ManoloMancelli/Persephone-3-Pro/README.md

# Persephone 3 Pro

Persephone 3 Pro is a DiY SteamVR headset which features full Lighthouse tracking (6DoF), pseudo-pancake lenses and 1440x1440 resolution per eye.

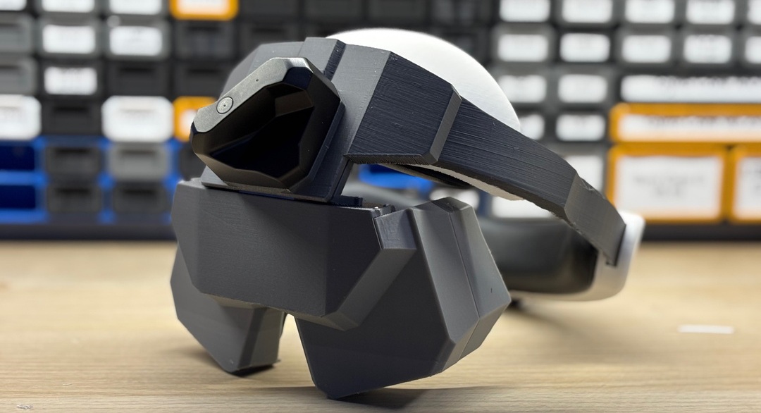
[picture p1: Releases/1.0/img/1.jpeg]


### Releases
- #### [Persephone 3 Pro 1.0](/Releases/1.0/1.0.md)
- #### [Persephone 3 Pro 1.1 - Wip](/Releases/1.1/1.1.md)

### Tutorials
- #### [SteamVR Tracking Override](/Tutorials/SteamVR%20Tracking%20Override/SteamVR%20Tracking%20Override.md)

### Software
- #### [HadesVR Eye Roll Fix](/Software/Eye%20Roll%20Fix/driver_hadesvr.dll)
- #### [Experimental HadesVR firmware for RP2040](/Software/Headset%20RP2040%20-%20Experimental)

### Reference
- #### [RP2040 Pro Micro Pinout](/Hardware/RP2040%20Pro%20Micro%20Pinout.png)
- #### [RP2040 Schematics](/Hardware/RP2040_Zero.pdf)
- #### [Waveshare RP2040 Zero Pinout](/Hardware/Waveshare%20RP2040%20Zero%20Pinout.png)
- #### [Waveshare RP2040 Zero Wiring](/Hardware/Wiring.png)
- #### [Face Tracking 1](https://www.reddit.com/r/VRchat/comments/1jbjmhd/25_wireless_face_tracking_for_vrchat/)
- #### [Face Tracking 2](https://steamcommunity.com/sharedfiles/filedetails/?id=3493715993)
- #### [Face Tracking 3](https://github.com/Project-Babble/ProjectBabble)
- #### [Eye Tracking 1](https://hackaday.com/2023/08/05/diy-eye-tracking-for-vr-headsets-from-a-to-z/)
- #### [Eye Tracking 2](https://docs.eyetrackvr.dev/getting_started/intro)
