ManoloMancelli/Persephone-3-Pro/Releases/1.0/1.0.md

# Persephone 3 Pro 1.0



## Parts
- #### [Display Set - LS029B3SX02](https://aliexpress.com/item/1005005565755501.html)
- #### [Tundra Tracker](https://tundra-labs.com/?srsltid=AfmBOoopuOi3vYniPcr9jf2mklbutnyBmwqGddzbK_AnHrIck0Ho1YlA)
- #### [2x Fresnel Lense - Diameter 70mm Focal Lenght 30mm](https://www.aliexpress.com/item/1005006877466030.html)
- #### [2x Fresnel Lense - Diameter 70mm Focal Lenght 40mm](https://www.aliexpress.com/item/1005006877466030.html)
- #### [Self Tapping Screws - M1.4 8mm](https://www.aliexpress.com/item/4000982209705.html)

## 3D files
You can use either CAD or STL files. CAD are meant to be used if you want to modify the design.

- #### [CAD Files](https://www.patreon.com/posts/150849423/)
- #### [STL Files](https://www.patreon.com/posts/150851033/)

## PCB files
This board uses all of the components which come with the original display kit.

You are meant to transfer them from the original PCB.

This board may be difficult to solder if you never soldered before!

- #### [MIPI Connector PCB](https://www.patreon.com/posts/151093496/)

## Tools
- #### [Lense Cutting Jig - Wip]()
- #### Hot air station
- #### Hot plate (Optional)

## Changelogs
- #### [Front Housing](/Changelogs/V1.0/Front%20Housing/Front%20Housing.md)
- #### [Headband](/Changelogs/V1.0/Headband/Headband.md)
- #### [Display Frame](/Changelogs/V1.0/Display%20Frame/Display%20Frame.md)
- #### [Optics](/Changelogs/V1.0/Optics/Optics.md)
- #### [Optics Housing](/Changelogs/V1.0/Optics%20Housing/Optics%20Housing.md)
- #### [IPD PCB](/Changelogs/V1.0/IPD%20PCB/IPD%20PCB.md)
