ManoloMancelli/Persephone-3-Pro/Changelogs/V1.0/Optics Housing/Optics Housing.md

# Persephone 3 Pro Optics Housing

A 3D printed optics housing which features Eye Tracking cameras and works with my custom pseudo pancake lenses.

## Optics Housing no. 1
Very first version of the Optics Housing. Based on the previous Persephone headsets.
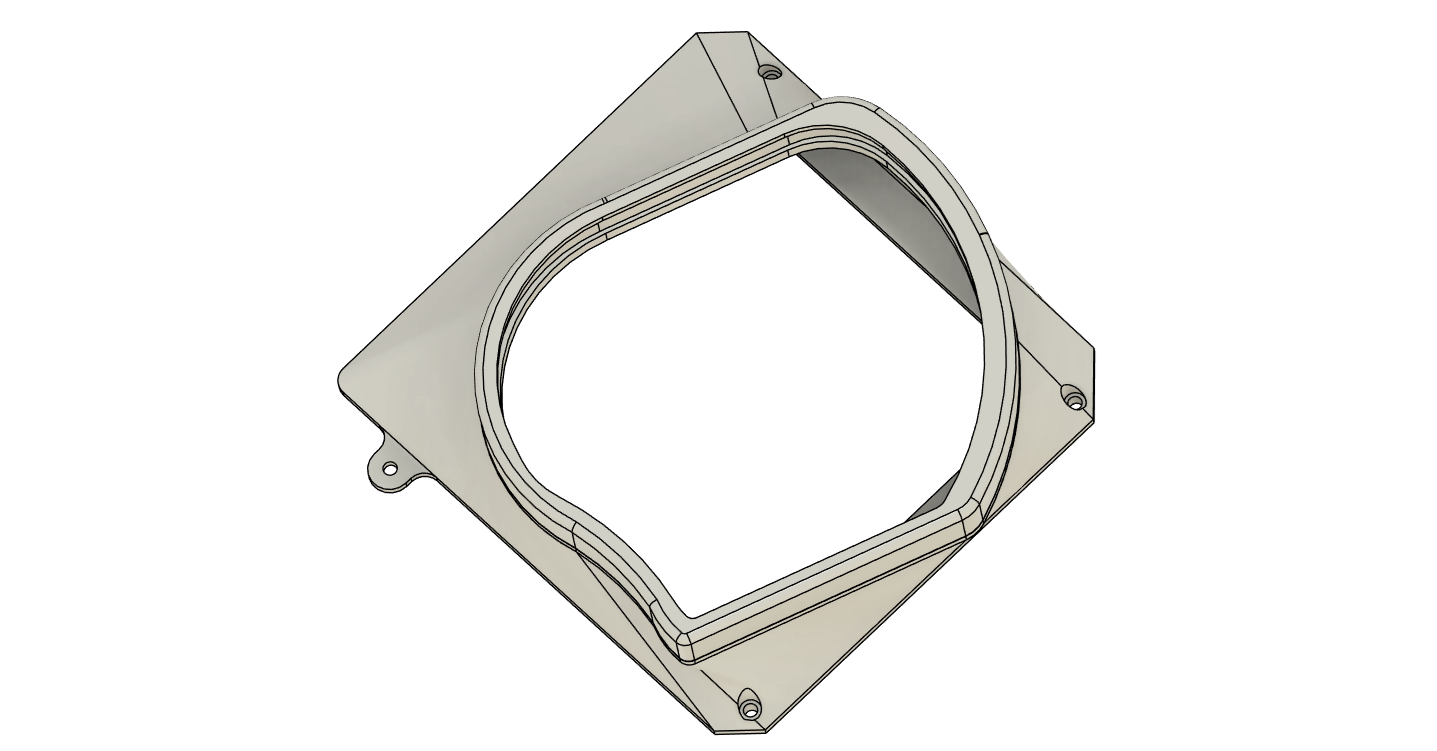
[picture p2: Changelogs/V1.0/Optics Housing/img/1/1.png]

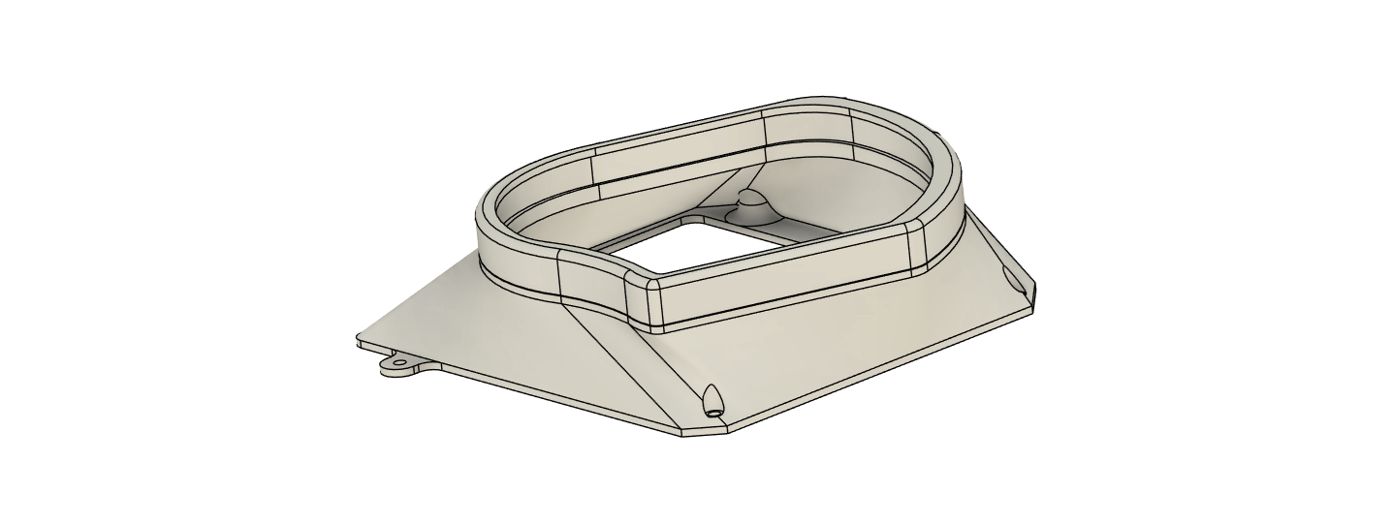
[picture p3: Changelogs/V1.0/Optics Housing/img/1/2.png]


## Optics Housing no. 2
- Modified the Optics Housing for use with new Lense trim
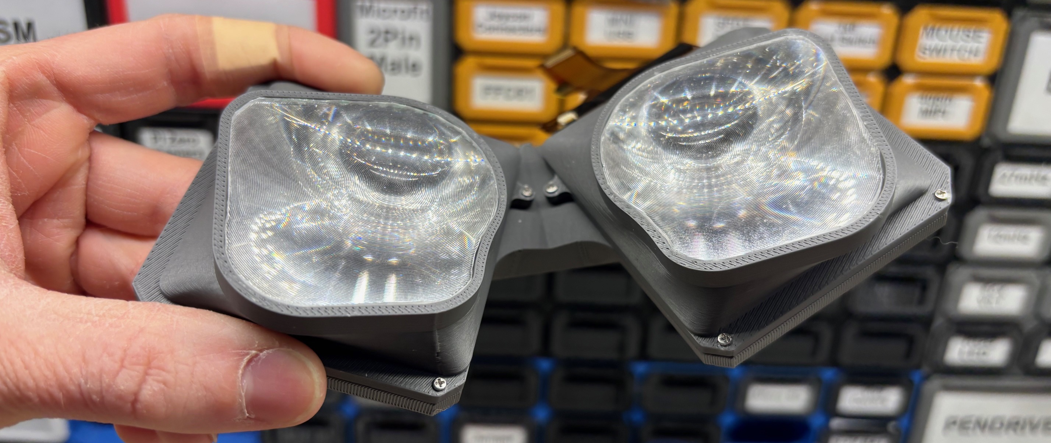
[picture p4: Changelogs/V1.0/Optics Housing/img/2/1.jpeg]

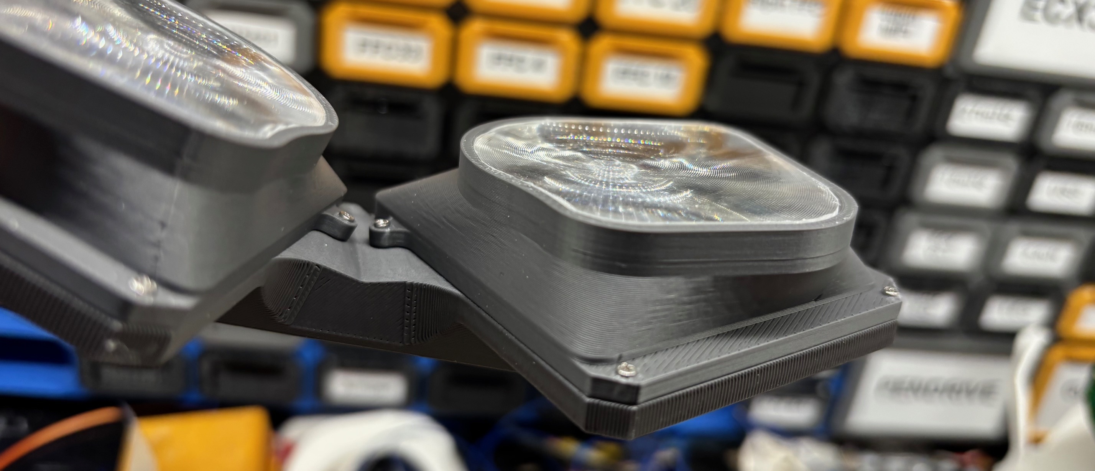
[picture p5: Changelogs/V1.0/Optics Housing/img/2/2.jpeg]

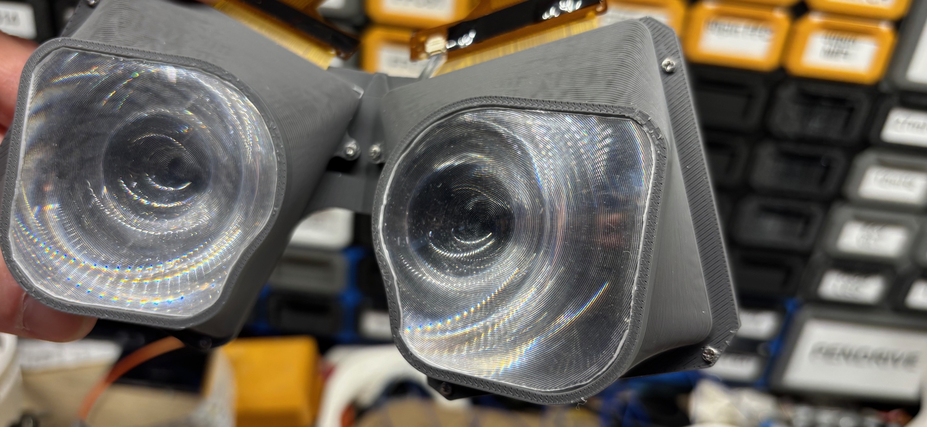
[picture p6: Changelogs/V1.0/Optics Housing/img/2/3.jpeg]


## Optics Housing no. 3
- Modified the Lense Holder for use with Lense Caps
- Added Lense Caps
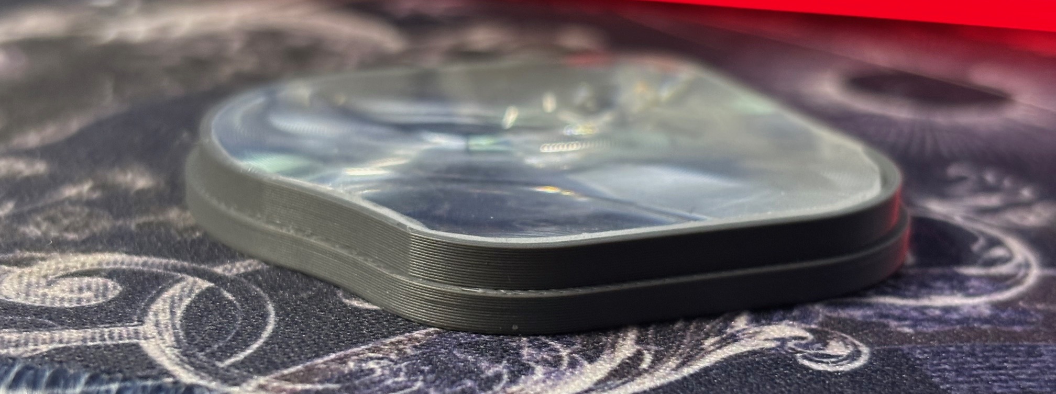
[picture p7: Changelogs/V1.0/Optics Housing/img/3/1.jpeg]

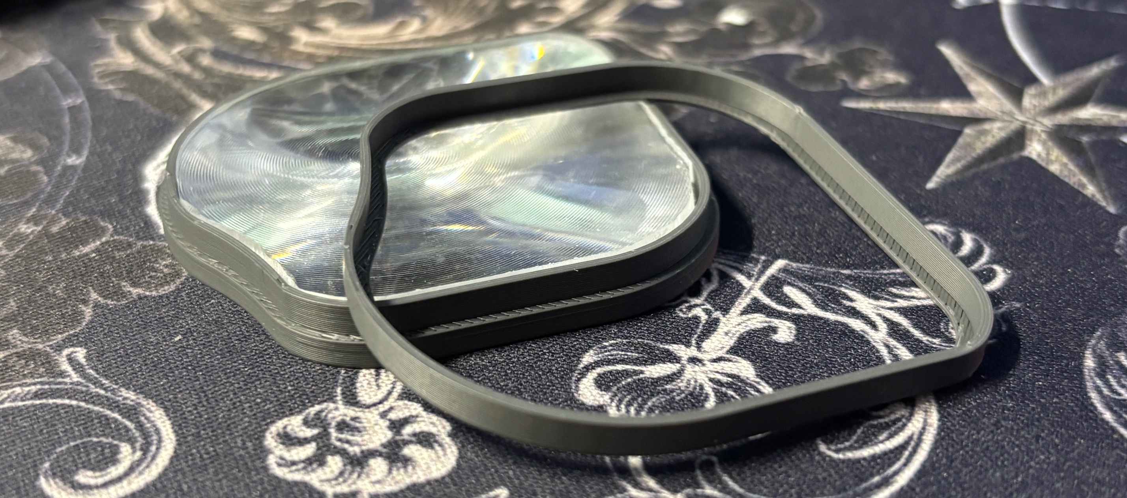
[picture p8: Changelogs/V1.0/Optics Housing/img/3/2.jpeg]
