ManoloMancelli/Persephone-3-Pro/Hardware/RP2040 Pro Micro Pinout.png

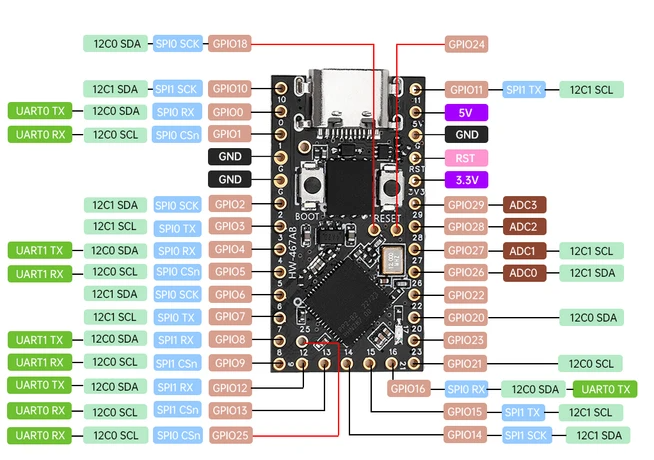
Hardware/RP2040 Pro Micro Pinout.png
