ManoloMancelli/Persephone-3-Pro/Hardware/Waveshare RP2040 Zero Pinout.png

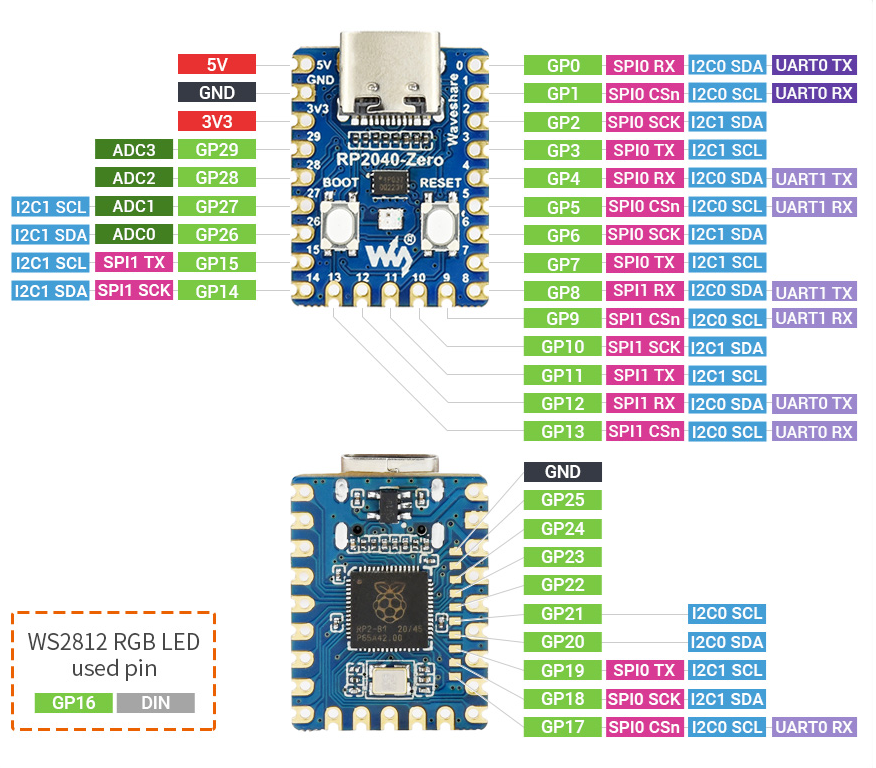
Hardware/Waveshare RP2040 Zero Pinout.png
