ManoloMancelli/Persephone-3-Pro/Releases/1.0/img/2.jpeg

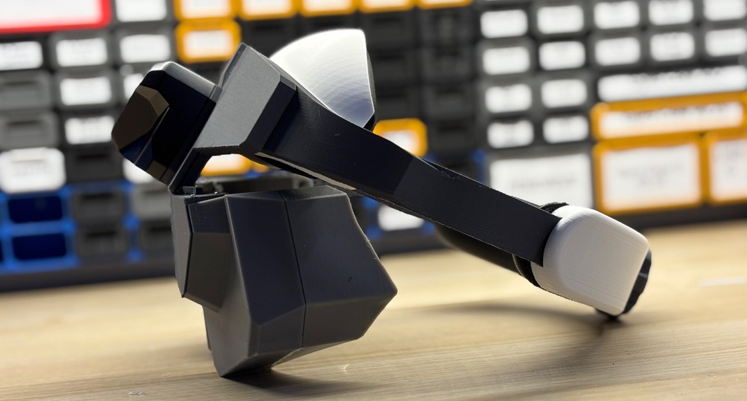
Releases/1.0/img/2.jpeg
