ManoloMancelli/Persephone-3-Pro/Hardware/Wiring.png

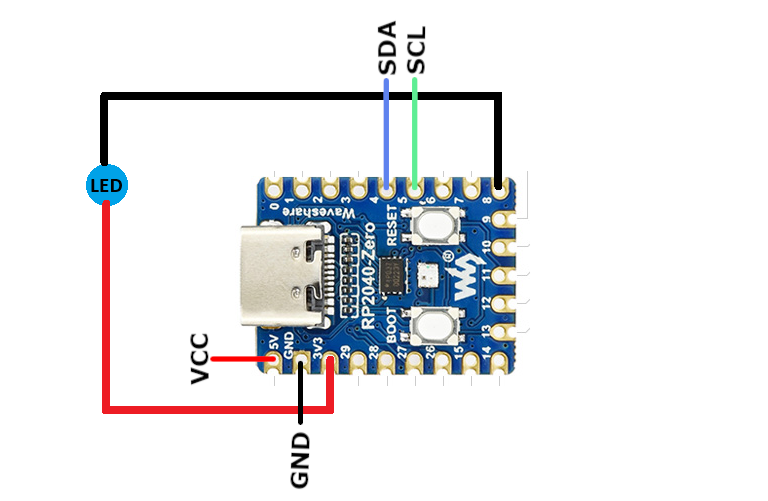
Hardware/Wiring.png
