ManoloMancelli/Persephone-3-Pro/Changelogs/Eye Tracking.md

# Persephone 3 Pro Eye Tracking
Experimental Eye Tracking for Persephone 3 Pro

## 26.01.2026

## TODO
- Check if regular webcam can be used
- Check what kind of material is required for hotmirror
- Check what kind of SteamVR support can be achieved

# References
## Hackaday Eye Tracking

Eye tracking is a useful feature in social virtual reality (VR) spaces because it really enhances presence and communication

when one’s avatar has a realistic gaze. Most headsets lack this feature,

but EyeTrackVR has a completely open source solution ready for anyone willing to put it together.

##

EyeTrackVR is a combination of hardware, software, and 3D printable mounts for attaching a pair of microcontroller boards,

cameras, and IR LEDs to just about any existing VR headset out there.

An ESP32-based board and tiny camera module watches each eyeball, and under IR illumination the pupil presents as an easily-identified round black area.

Software takes care of turning the camera’s view of the pupil into a gaze direction value that can be plugged into other software.

##

The project is still under active development, but in its current state is perfectly suitable for creating a functional system

that can integrate into a variety of existing headsets with printed mounting brackets. 

Interested? Check out the intro and if it sounds up your alley, dive into the build guide which spells out everything you need to know.

## Eye Tracking no. 1
- Find a suitable, small camera
- Look into "hot mirrors"
- Build a prototype
