ManoloMancelli/Persephone-3-Pro/Changelogs/HDMI Breakout PCB.md

# Persephone 3 Pro HDMI Breakout PCB
A Simple DiY PCB which aims to replace the HDMI and USB connectors on the display driver board with more modern variants while also making it possible to move the connectors to a different location
