ManoloMancelli/Persephone-3-Pro/Changelogs/V3.0/Changelog.md

# Persephone 3 Pro Changelog

- #### [Front Housing](/Changelogs/Front%20Housing/Front%20Housing.md)
- #### [Visor](/Changelogs/Visor.md)
- #### [Headband](/Changelogs/Headband/Headband.md)
- #### [Display Frame](/Changelogs/Display%20Frame/Display%20Frame.md)
- #### [Optics](/Changelogs/Optics/Optics.md)
- #### [Optics Housing](/Changelogs/Optics%20Housing/Optics%20Housing.md)
- #### [IPD Mechanism](/Changelogs/IPD%20Mechanism.md)
- #### [IPD PCB](/Changelogs/IPD%20PCB/IPD%20PCB.md)
- #### [HDMI Breakout PCB](/Changelogs/HDMI%20Breakout/HDMI%20Breakout%20PCB.md)
- #### [Eye tracking](/Changelogs/Eye%20Tracking.md)
- #### [Face Tracking](/Changelogs/Face%20Tracking/Face%20Tracking.md)
