ManoloMancelli/Persephone-3-Pro/Changelogs/V1.1/V1.1.md

# Persephone 3 Pro V1.1 Changelog

## 1.03.2026
- Modeled initial version of the TPU Light Blockers
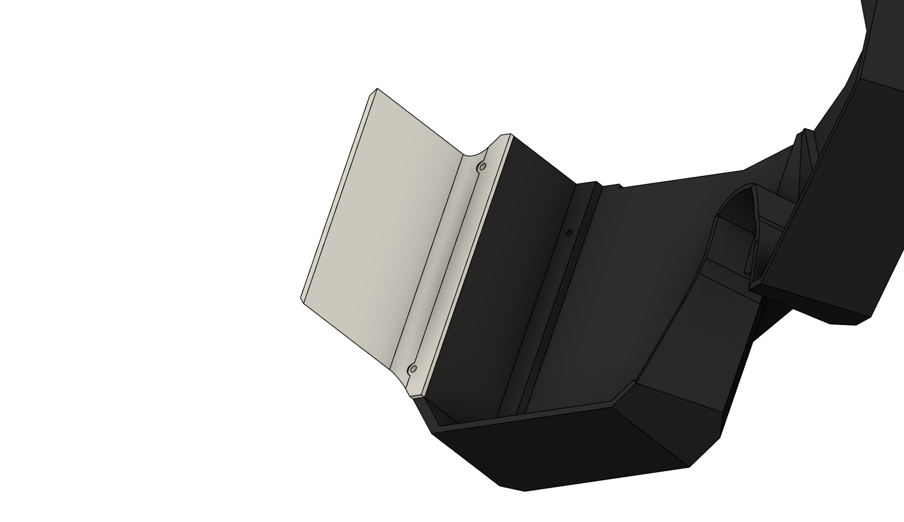
[picture p26: Changelogs/V1.1/1.03.2026/1.png]


## 2.03.2026
- Changed Optics mounting system to slide-in
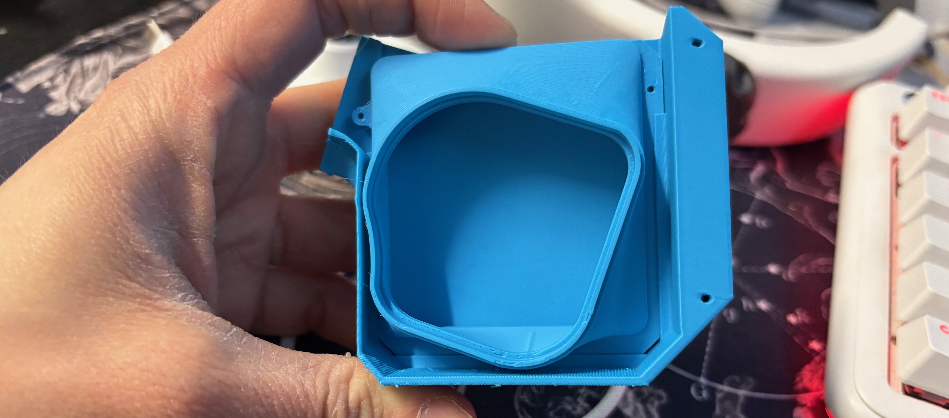
[picture p27: Changelogs/V1.1/2.03.2026/1.jpeg]


## 6.03.2026
- Added Persephone 3 Pro logo on the top part of Rear Headband Mechanism
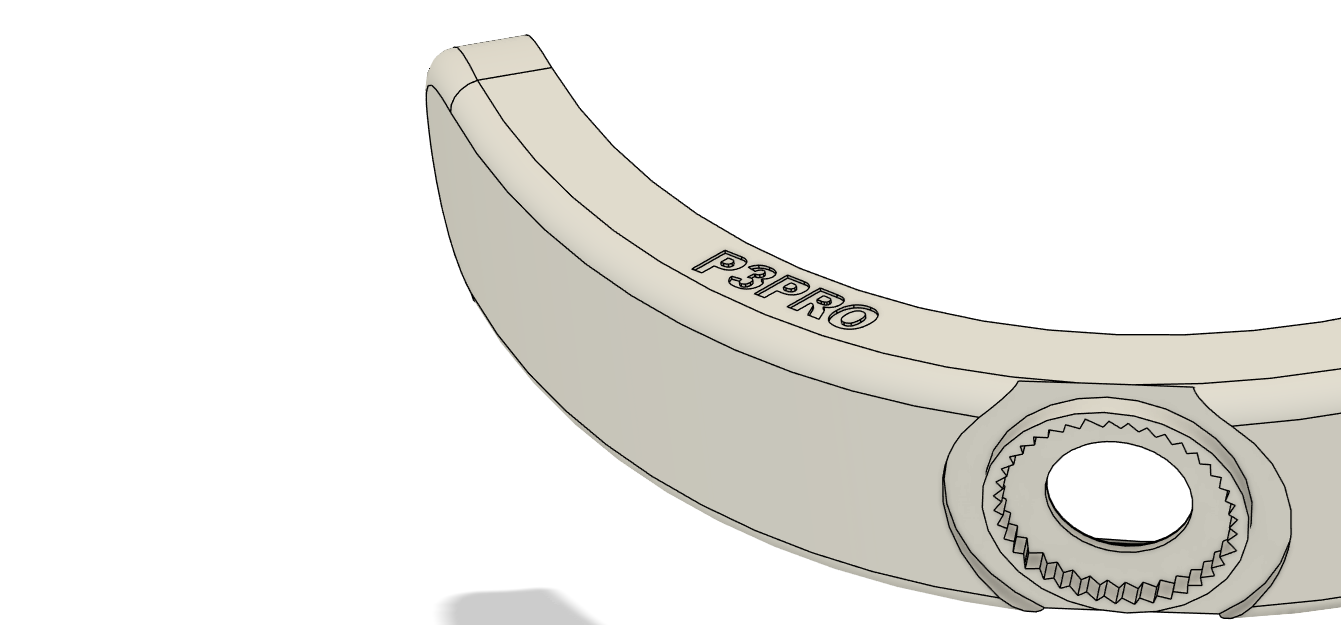
[picture p28: Changelogs/V1.1/6.03.2026/1.png]


- Made the Rear Headband Mechanism Cover mounting points tighter
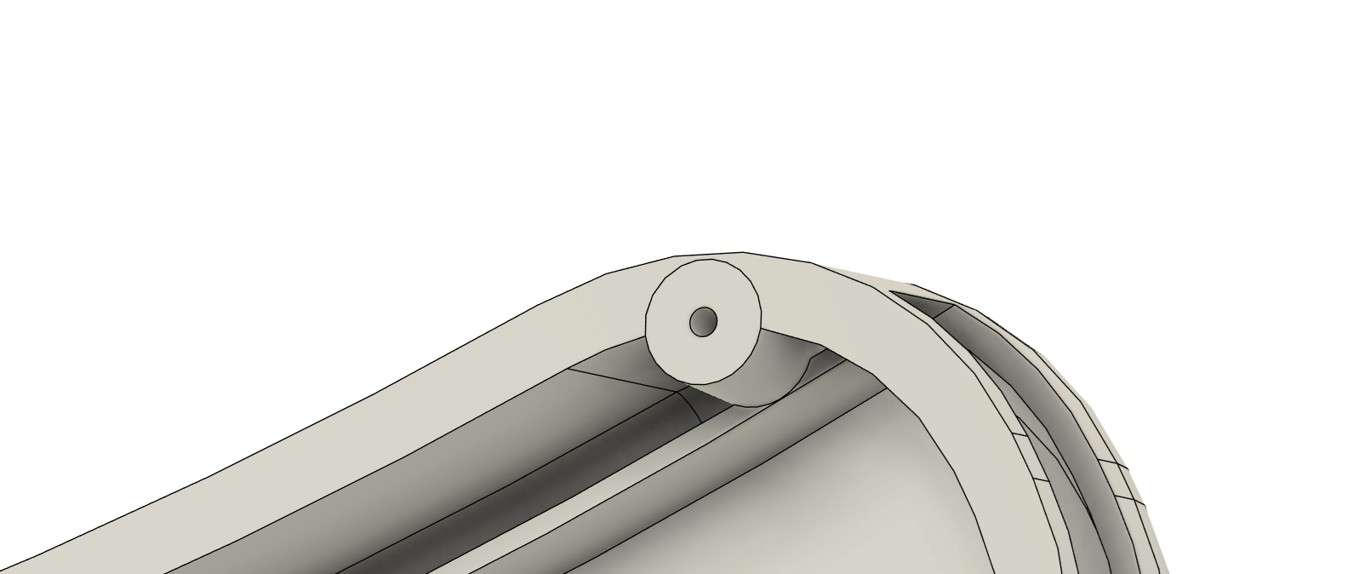
[picture p29: Changelogs/V1.1/6.03.2026/2.png]


- Made the Strap openings on the Rear Headband Mechanism slightly narrower
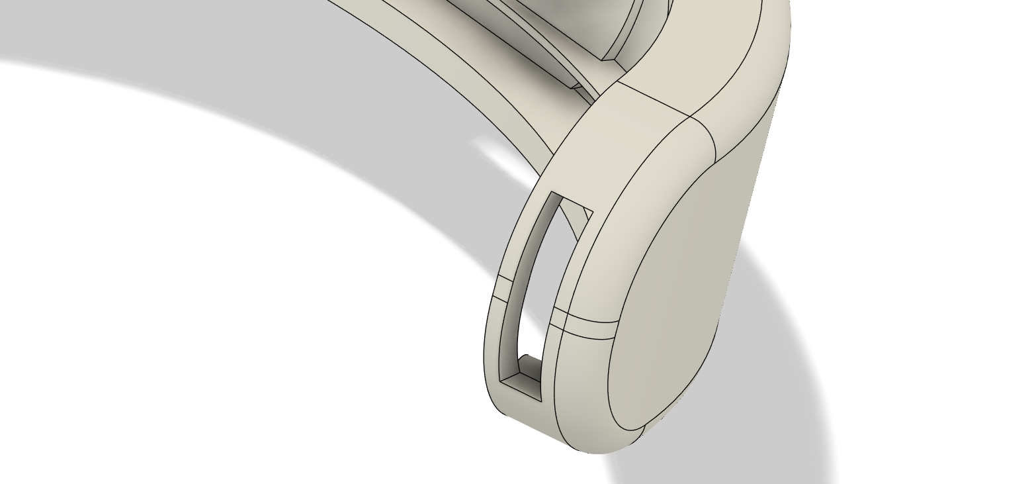
[picture p30: Changelogs/V1.1/6.03.2026/3.png]


- Extended the Rear Headband Mechanism Cover center mounting points to the sides
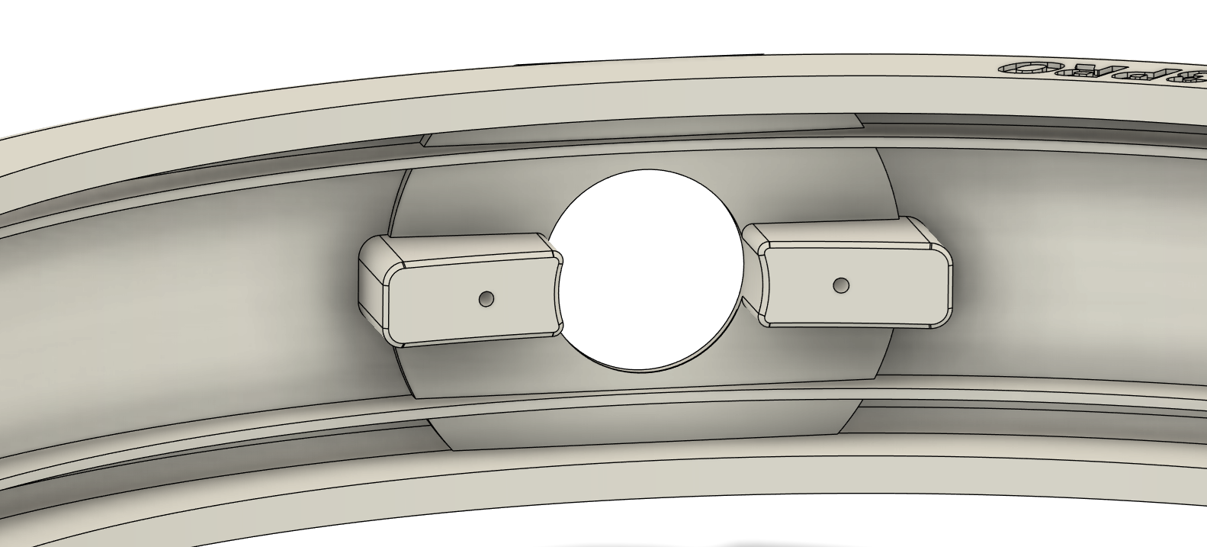
[picture p31: Changelogs/V1.1/6.03.2026/4.png]


- Modified the Knob for the stationary logo
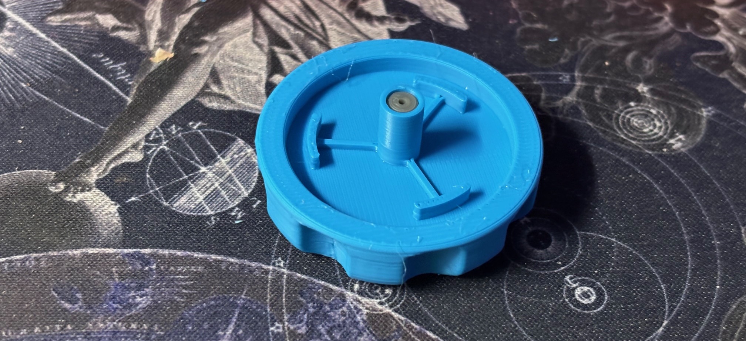
[picture p32: Changelogs/V1.1/6.03.2026/5.jpeg]

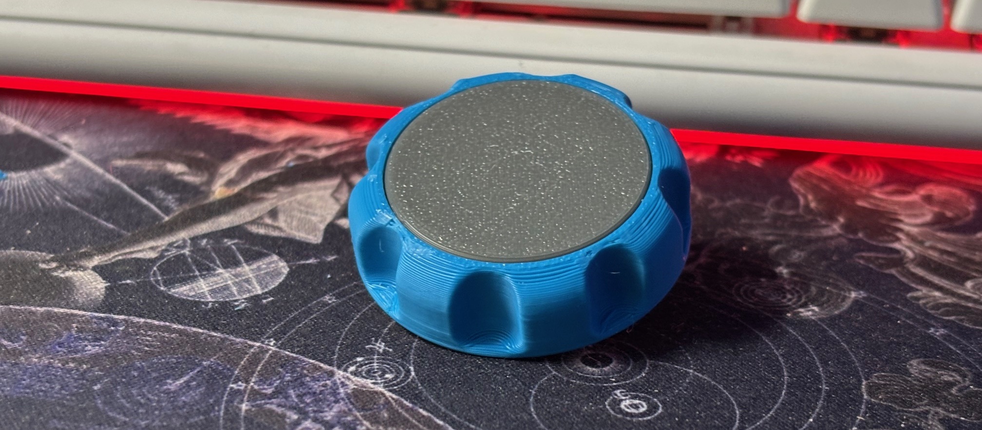
[picture p33: Changelogs/V1.1/6.03.2026/6.jpeg]


- Merged Knob Lock with Headband Mechanism Cover
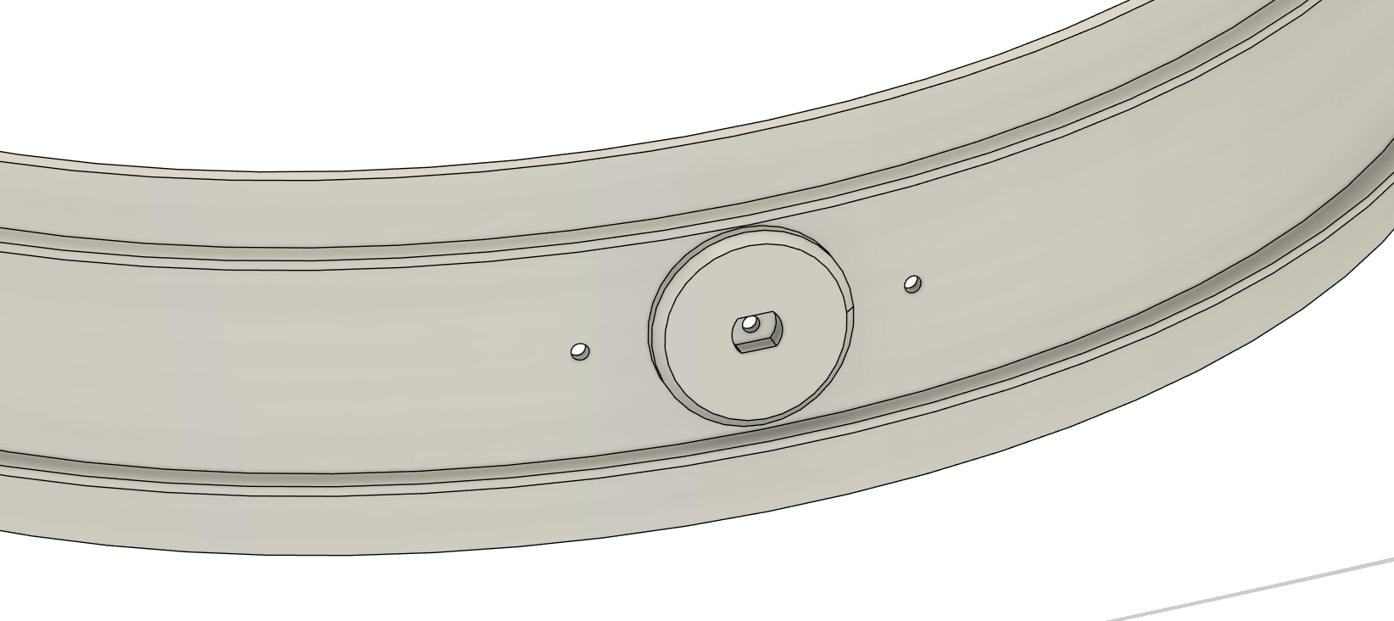
[picture p34: Changelogs/V1.1/6.03.2026/7.png]


- Added Logo on the Knob
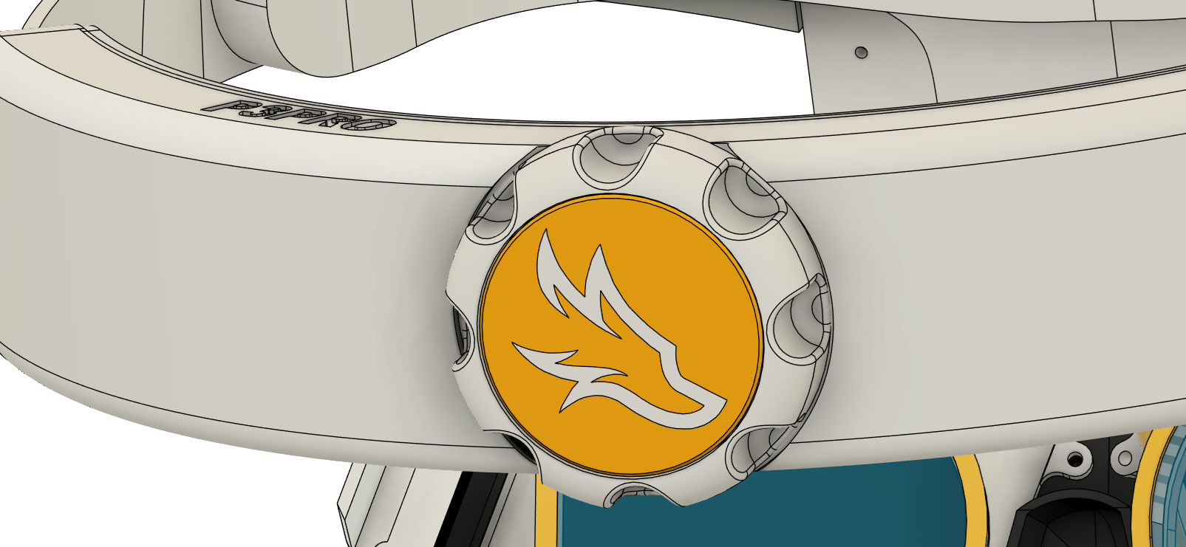
[picture p35: Changelogs/V1.1/6.03.2026/8.png]


- Changed Halo-Headset mounting system to slide-in
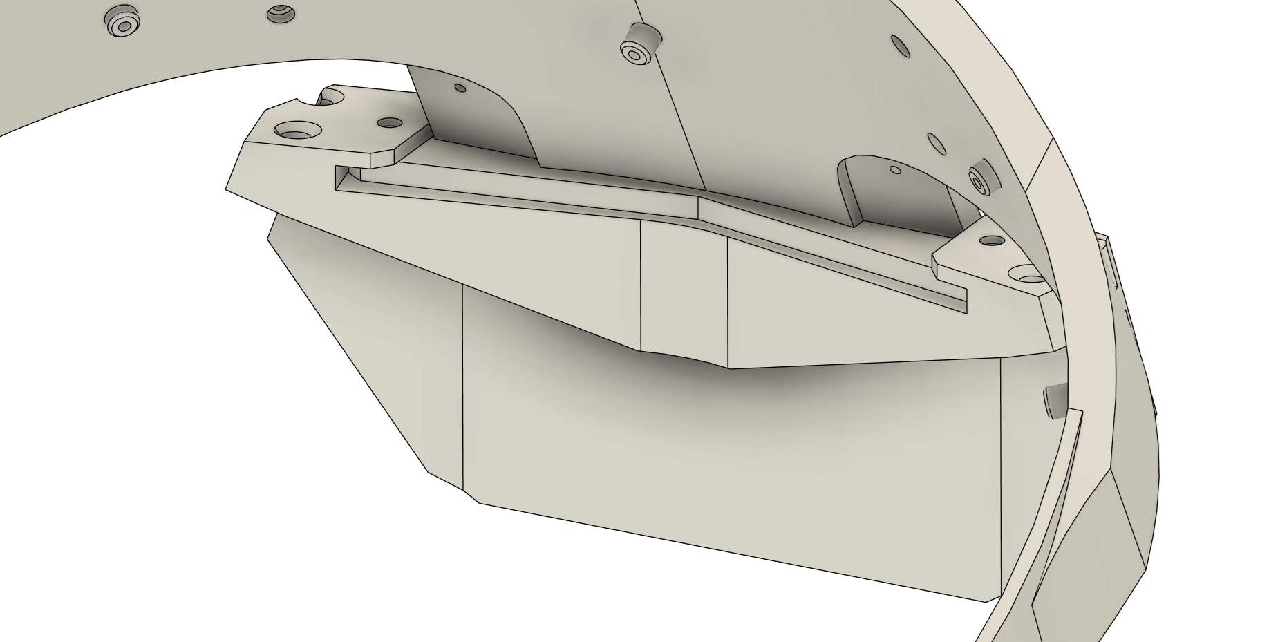
[picture p36: Changelogs/V1.1/6.03.2026/9.png]


## 7.03.2026
- Improved the Rear Headband Mechanism geometry
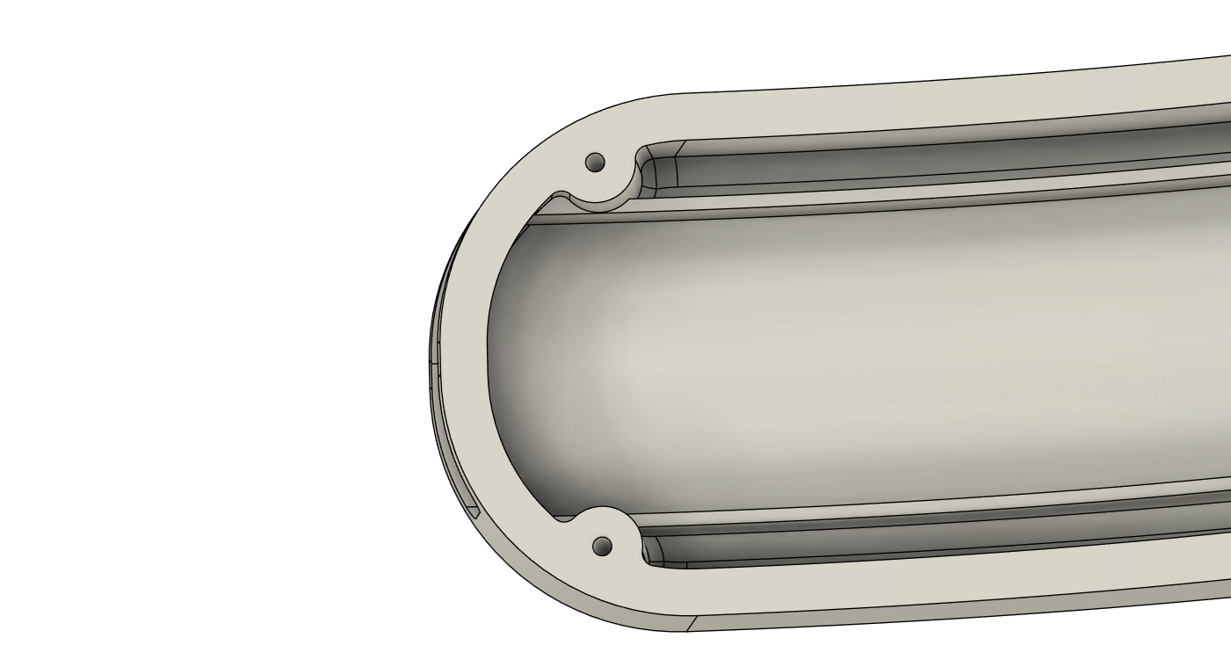
[picture p37: Changelogs/V1.1/7.03.2026/1.png]


- Made the Display Frame slightly wider
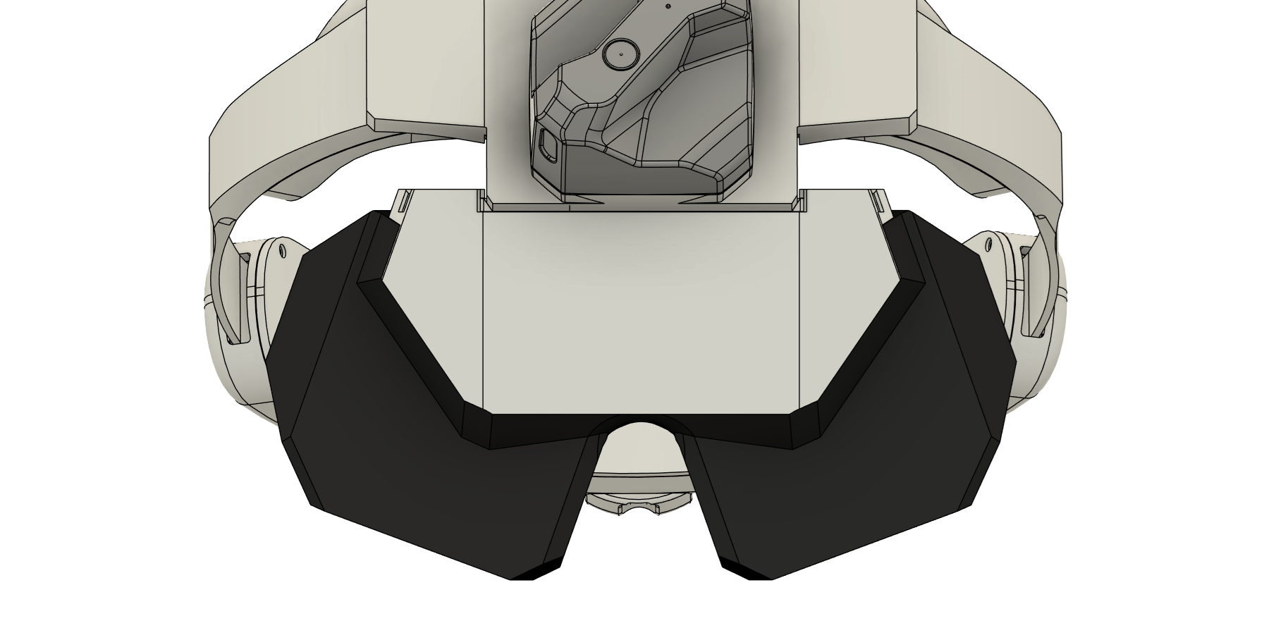
[picture p38: Changelogs/V1.1/7.03.2026/2.png]


- Extended Headstrap "Endstops"
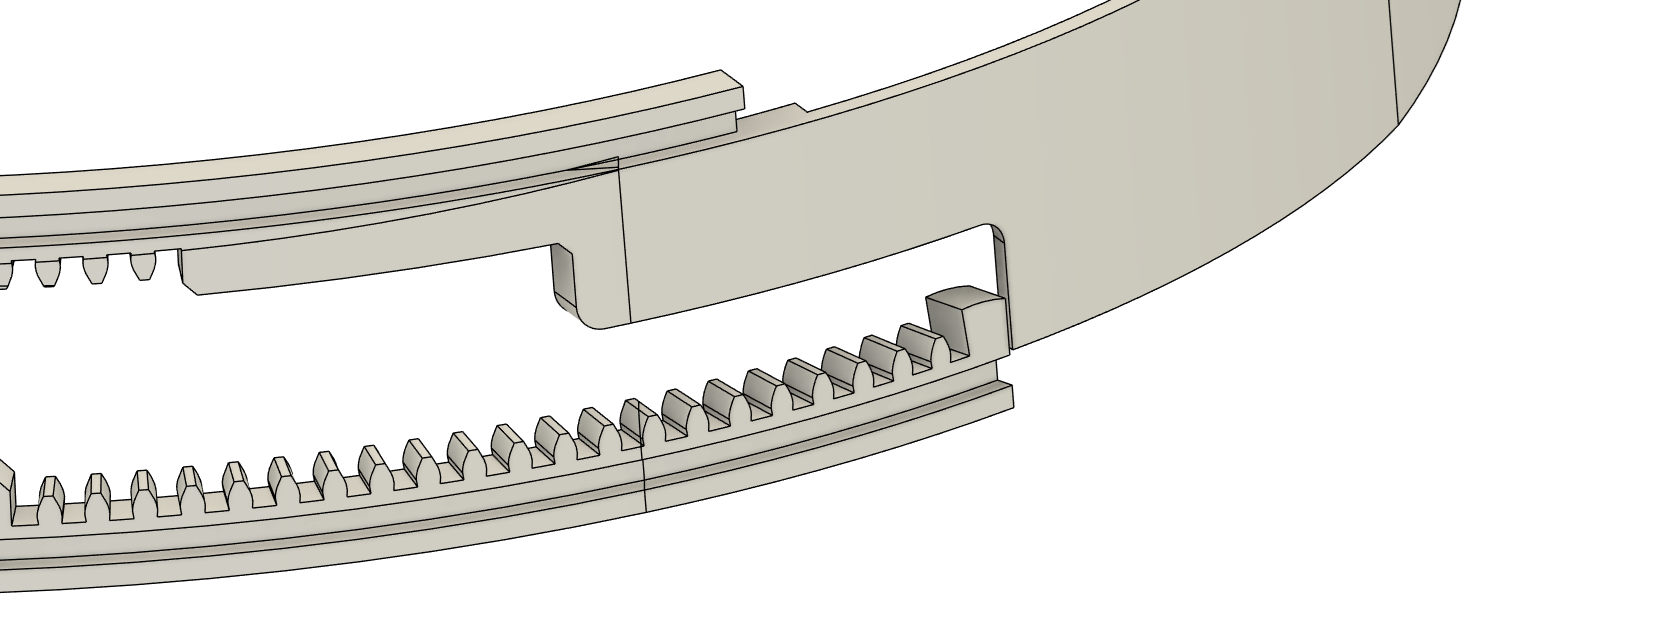
[picture p39: Changelogs/V1.1/7.03.2026/3.png]


## 14.03.2026
- Moved the strap cutout covers to the Rear Headband Cover
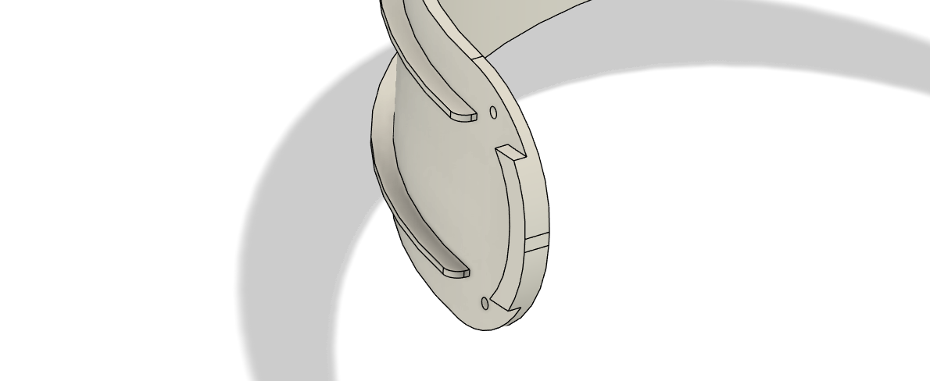
[picture p40: Changelogs/V1.1/14.03.2026/1.png]


- Added Strap max limiter
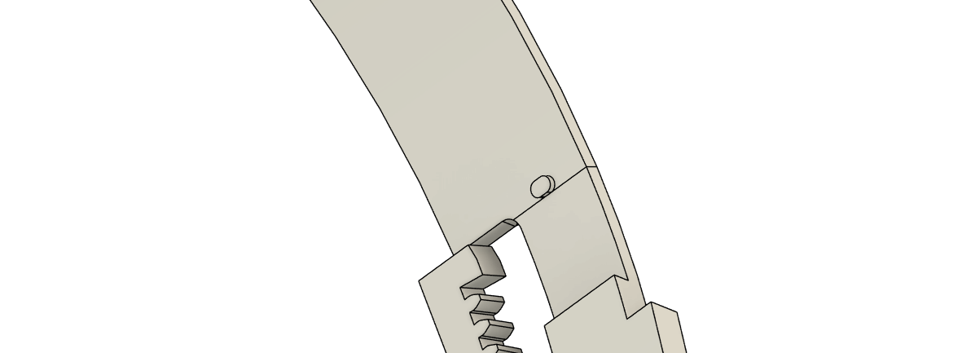
[picture p41: Changelogs/V1.1/14.03.2026/2.png]


- Adjusted the USB and HDMI cutouts on the Headband
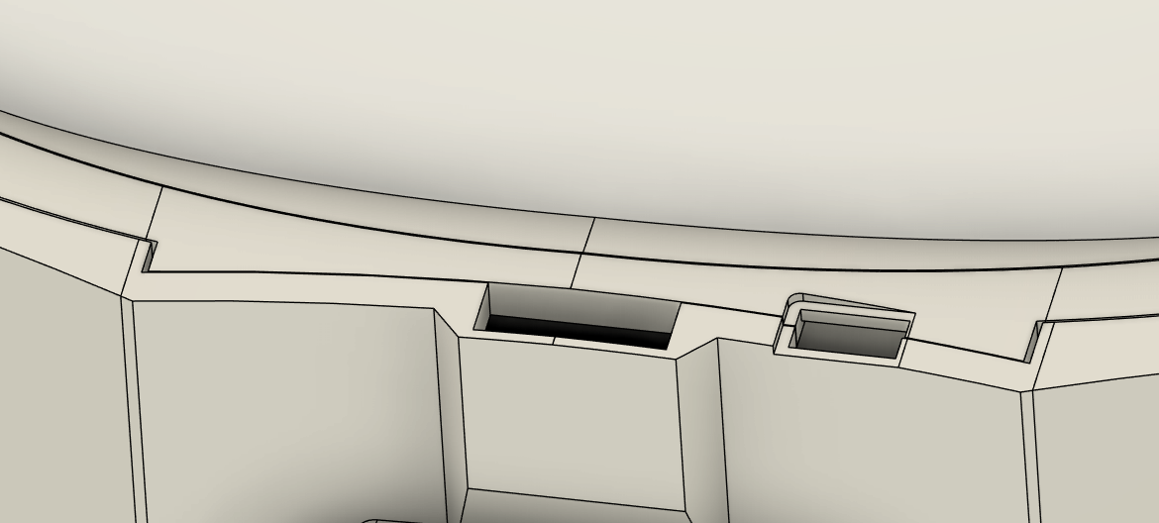
[picture p42: Changelogs/V1.1/14.03.2026/3.png]


## 16.03.2026
- Extended the Strap max limiters
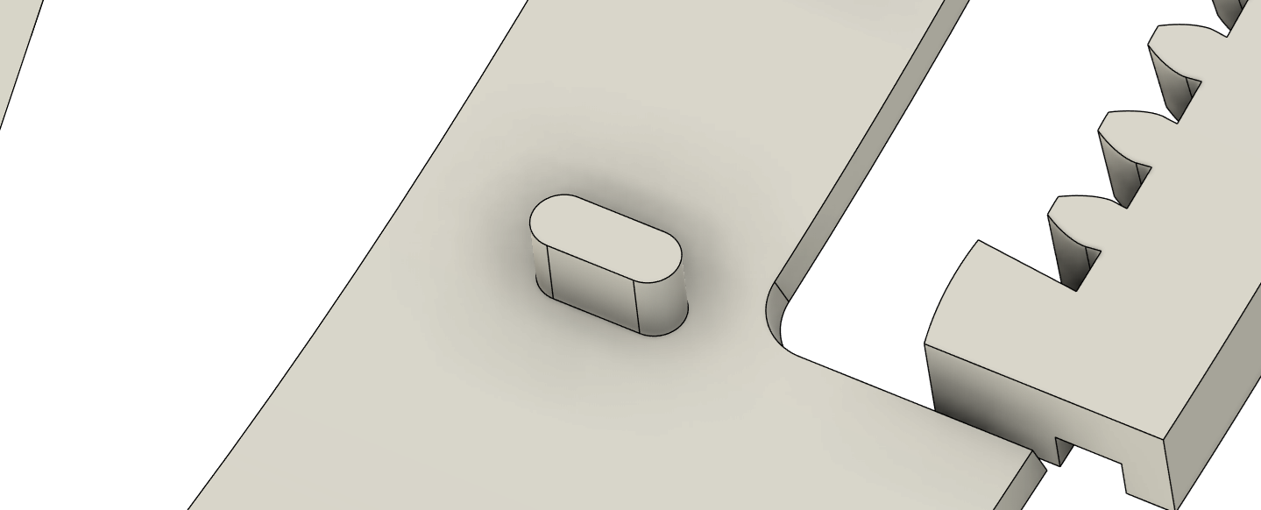
[picture p43: Changelogs/V1.1/16.03.2026/1.png]


## 17.03.2026
- Adjusted the Strap Gear tolerances
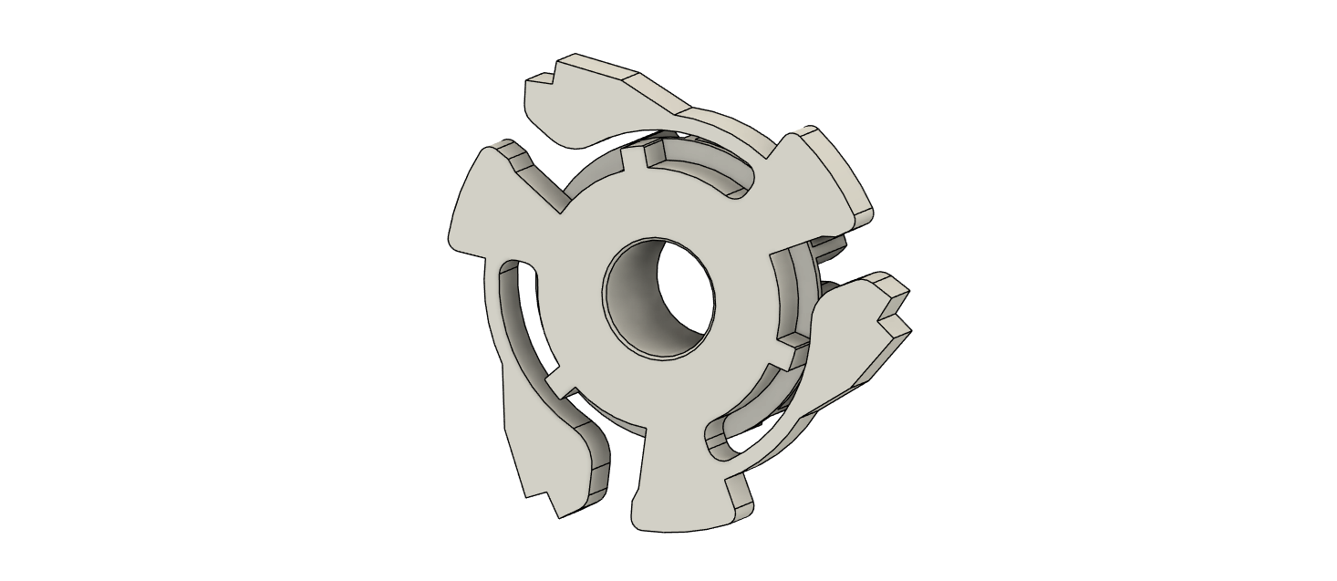
[picture p44: Changelogs/V1.1/17.03.2026/1.png]


- Designed the Facial Interface Frame
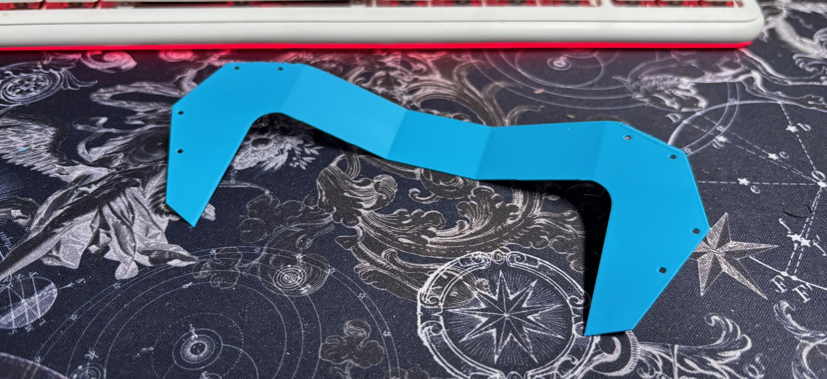
[picture p45: Changelogs/V1.1/17.03.2026/2.jpeg]


## TODO
- Design TPU Light Blockers
- Add cable guide
- Fix HDMI and USB cutouts
- Add Eye Tracking
- Add Face Tracking
