ManoloMancelli/Persephone-3-Pro/Changelogs/V1.0/IPD PCB/IPD PCB.md

# Persephone 3 Pro IPD PCB
A Custom PCB designed for the Persephone 3 Pro. It features angled MIPI connectors for wider IPD range

## IPD PCB no. 1
Very first PCB version. Basically a manufacturer's board recreation.

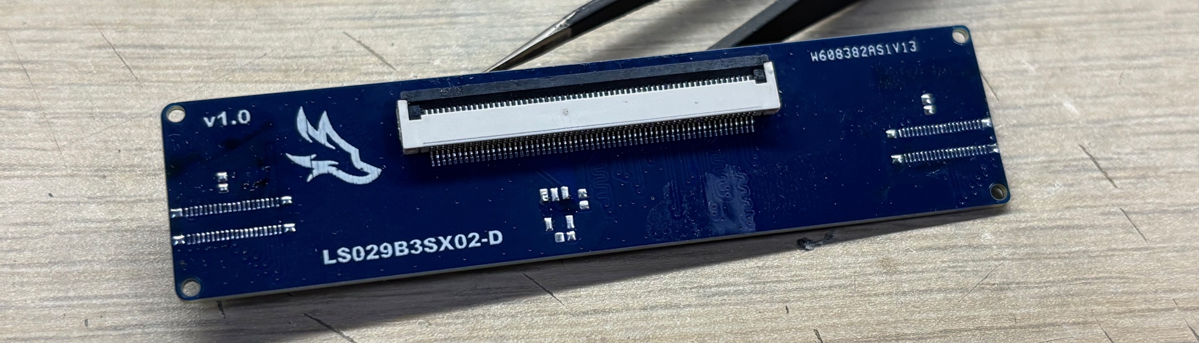
[picture p46: Changelogs/V1.0/IPD PCB/img/1/1.jpeg]


## IPD PCB no. 2
First customized PCB. Features angled MIPI display connectors for wider IPD range.

FFC ribbons are now perfectly safe from tearing since there is no stress from angling the panels.

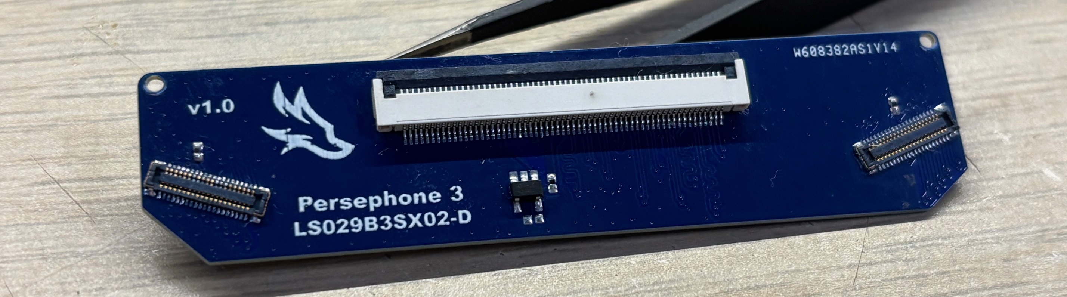
[picture p47: Changelogs/V1.0/IPD PCB/img/2/1.jpeg]


## IPD PCB no. 3
New, experimental PCB which now features built-in gyroscope module
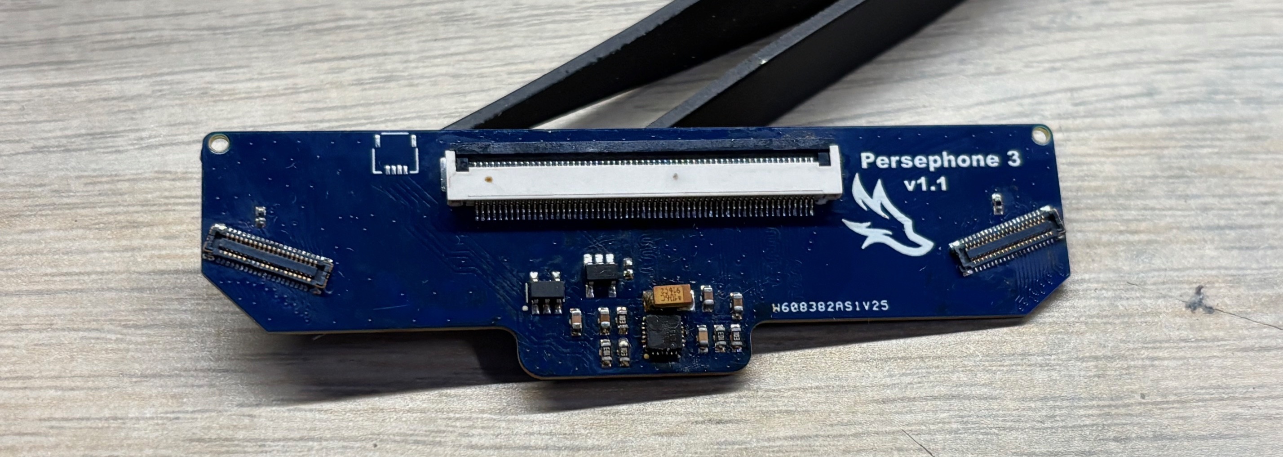
[picture p48: Changelogs/V1.0/IPD PCB/img/3/1.jpeg]
