ManoloMancelli/Persephone-3-Pro/Changelogs/V1.0/Display Frame/Display Frame.md

# Persephone 3 Pro Display Frame
Fully 3D printed frame for 2 1440x1440 displays

## Display Frame no. 1
- 3D modeled the initial version

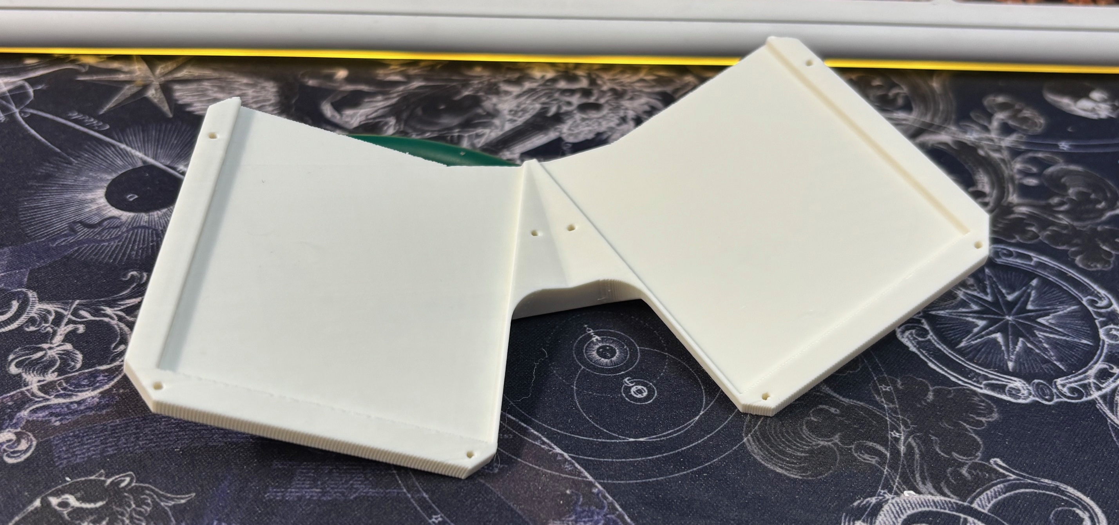
[picture p49: Changelogs/V1.0/Display Frame/img/1/1.jpeg]

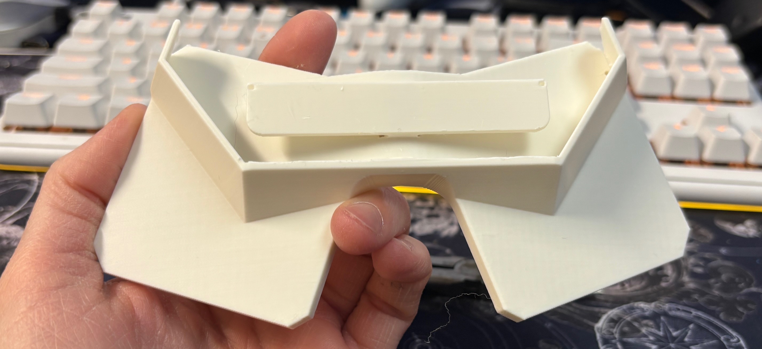
[picture p50: Changelogs/V1.0/Display Frame/img/1/2.jpeg]

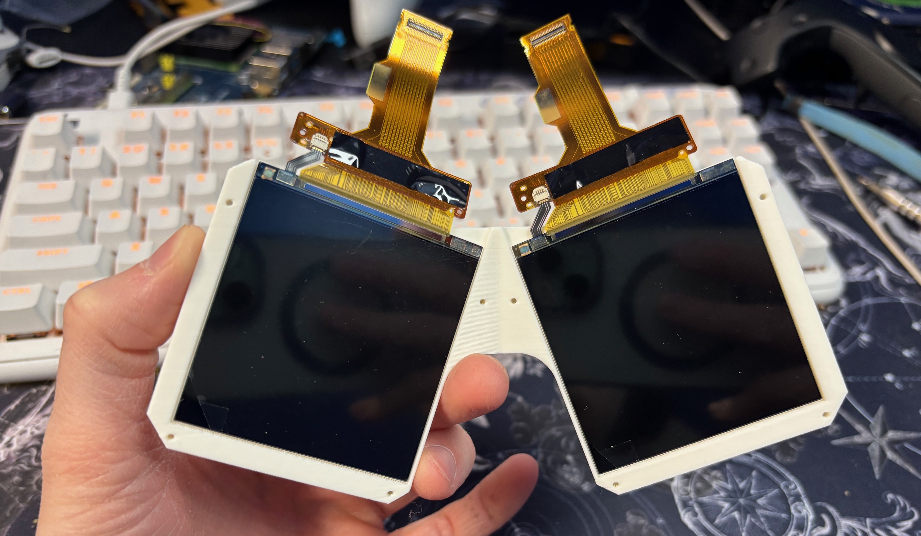
[picture p51: Changelogs/V1.0/Display Frame/img/1/3.jpeg]


## Display Frame no. 2
- Fixed the top corners
- Made the top cornes slightly longer than rest of the frame
- Added mounting points on the top corners
- Modified the corners near display connectors to be less aggressive
- Made slightly more space for the IPD PCB near the gyroscope
- Fixed the geometry behind the IPD PCB mount
- Made the center column of the IPD mount slightly wider
- Improved the IPD PCB mounting points
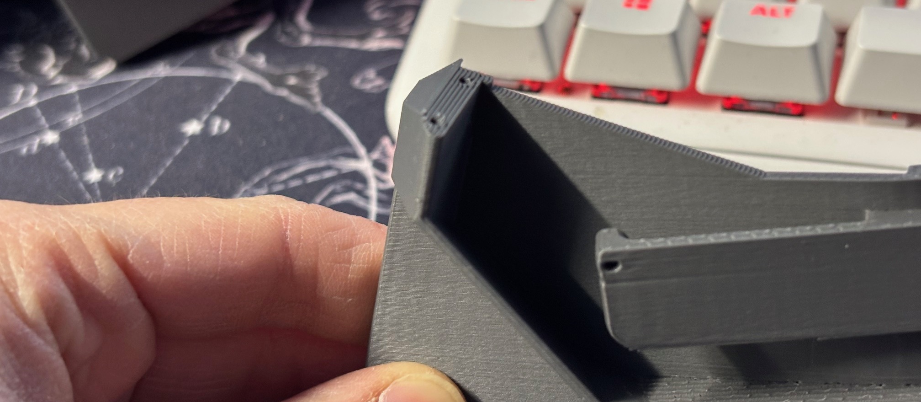
[picture p52: Changelogs/V1.0/Display Frame/img/2/1.jpeg]

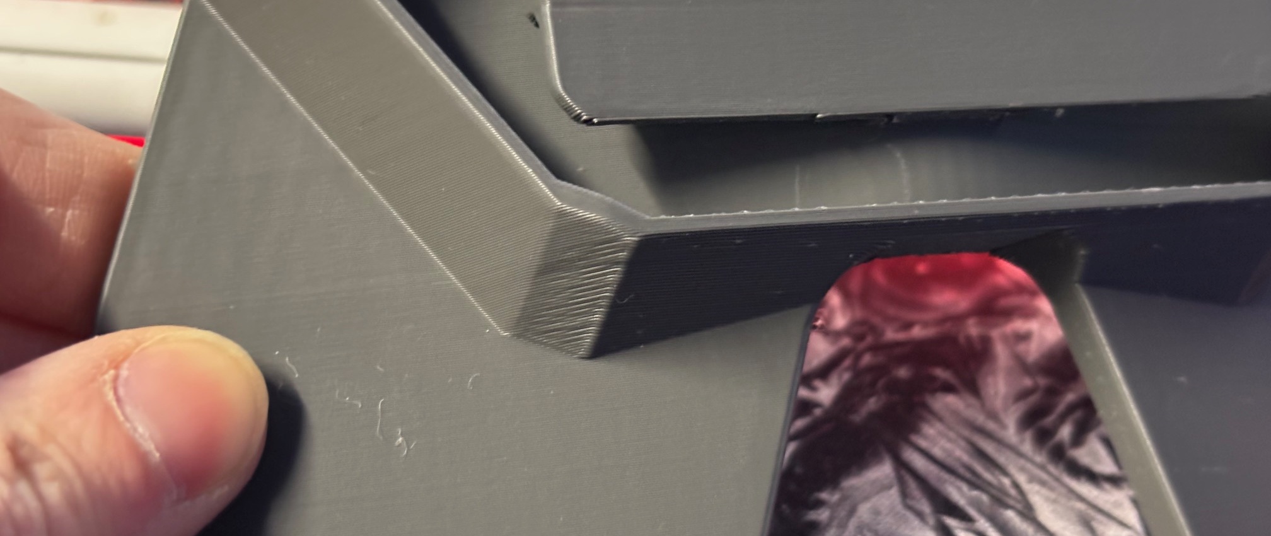
[picture p53: Changelogs/V1.0/Display Frame/img/2/2.jpeg]

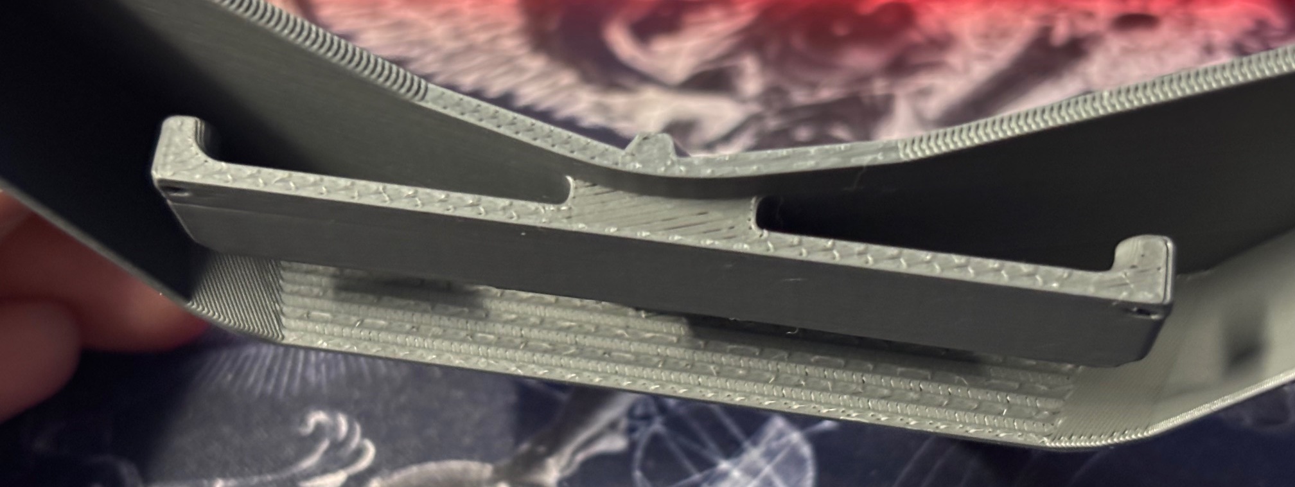
[picture p54: Changelogs/V1.0/Display Frame/img/2/3.jpeg]


## Display Frame no. 3
- Added basic Screen Lock
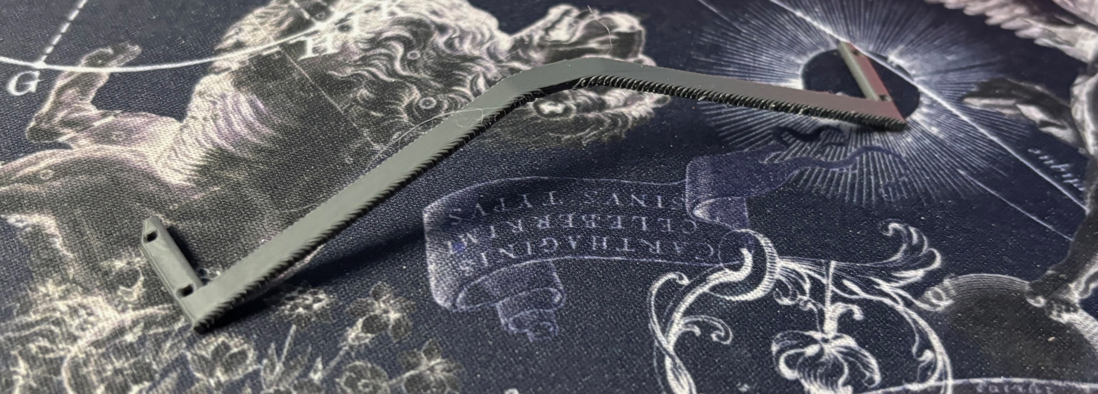
[picture p55: Changelogs/V1.0/Display Frame/img/3/1.jpeg]


- Modified Screen Lock into Front Housing
