ManoloMancelli/Persephone-3-Pro/Changelogs/V1.0/Headband/Headband.md

# Persephone 3 Pro Headband
A Fully 3D printed Halo VR headband

## Headband No. 0
Very first version of the Headband

- 3D Scaned the Mirage Solo headband
- Processed the 3D scan for CAD use
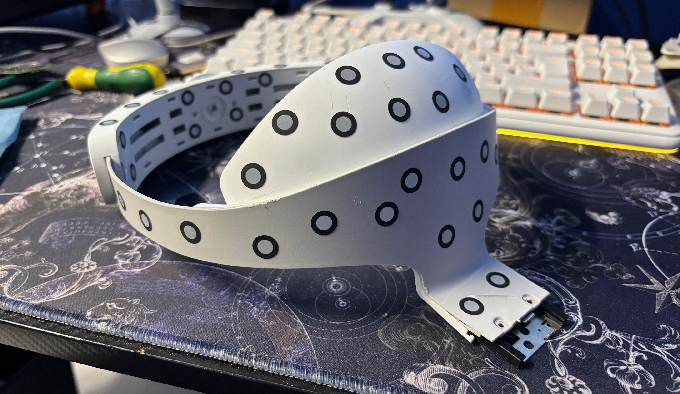
[picture p56: Changelogs/V1.0/Headband/img/0/1.jpeg]


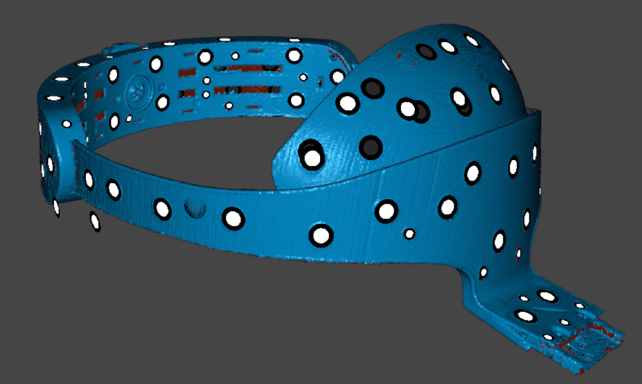
[picture p57: Changelogs/V1.0/Headband/img/0/2.png]


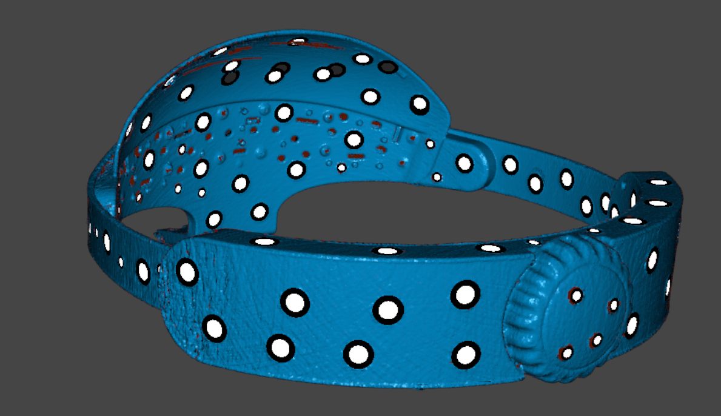
[picture p58: Changelogs/V1.0/Headband/img/0/3.png]


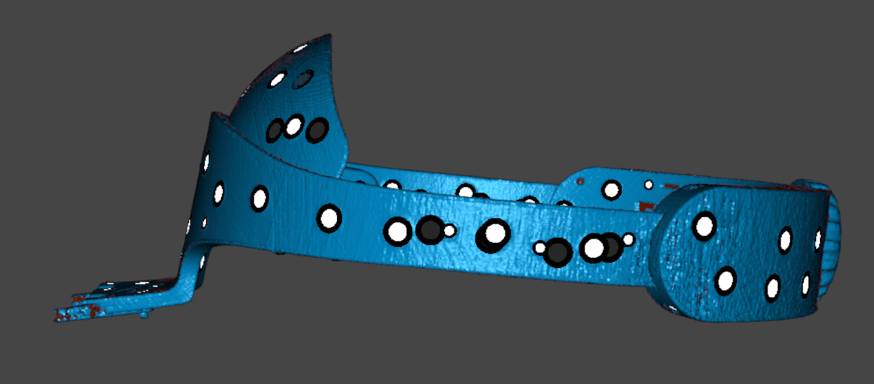
[picture p59: Changelogs/V1.0/Headband/img/0/4.png]


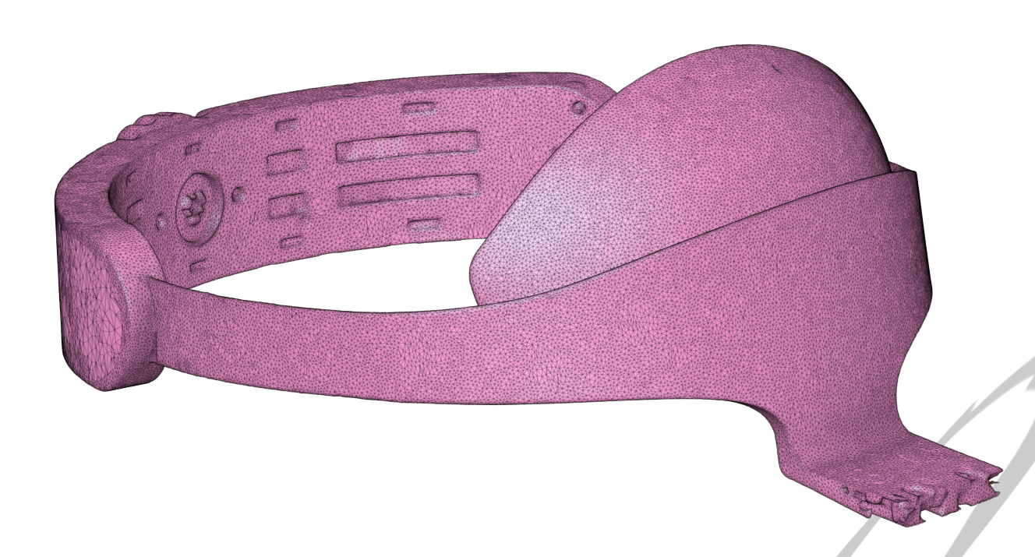
[picture p60: Changelogs/V1.0/Headband/img/0/5.png]


## Headband no.1

 - Refined the CAD model to simpler shape
 
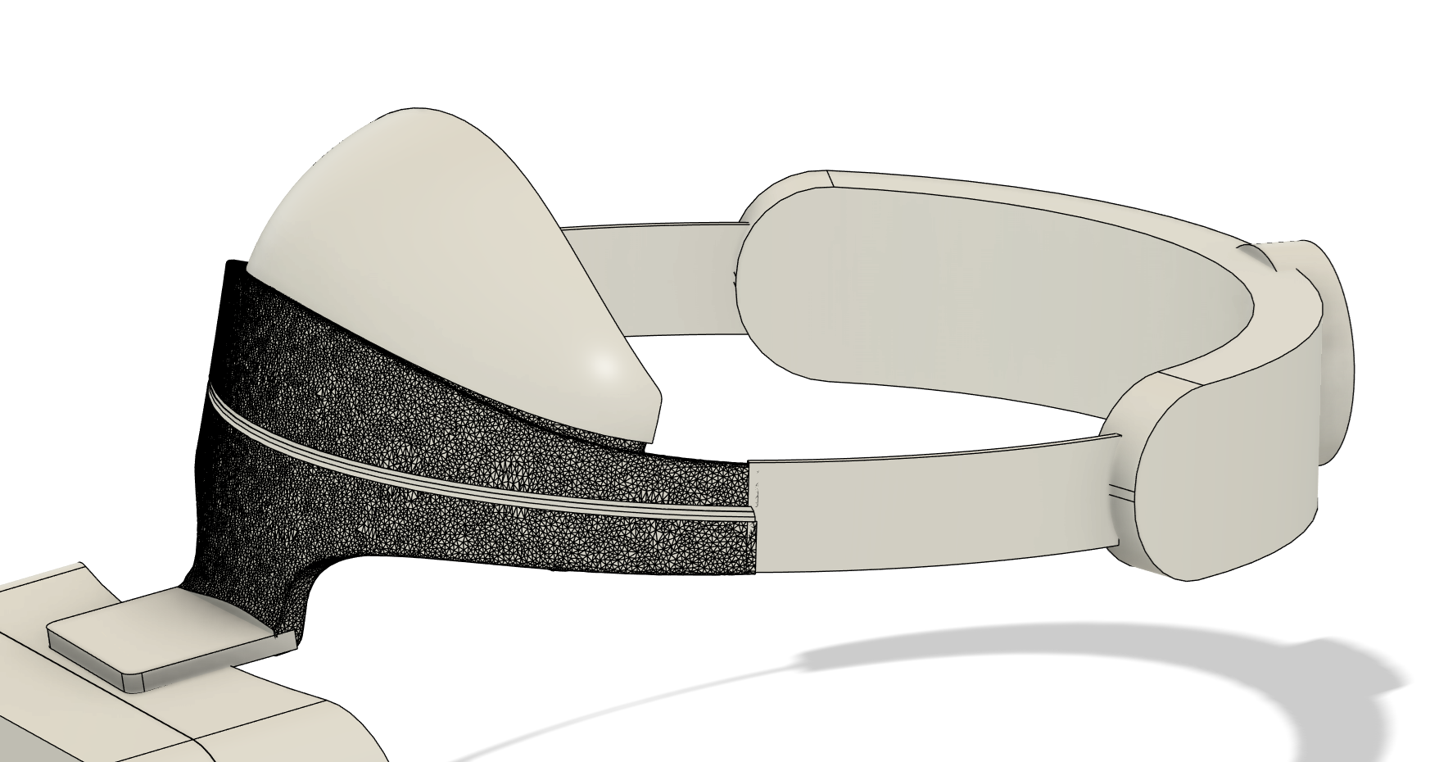
[picture p61: Changelogs/V1.0/Headband/img/1/1.png]
 
 
 ## Headband no.2
 
 - Further refined the whole Headband
 - Made initial geared strap
 - Re-meshed the back mechanism
 - Added the knob and gear
 - Added gear teeth to the strap
 
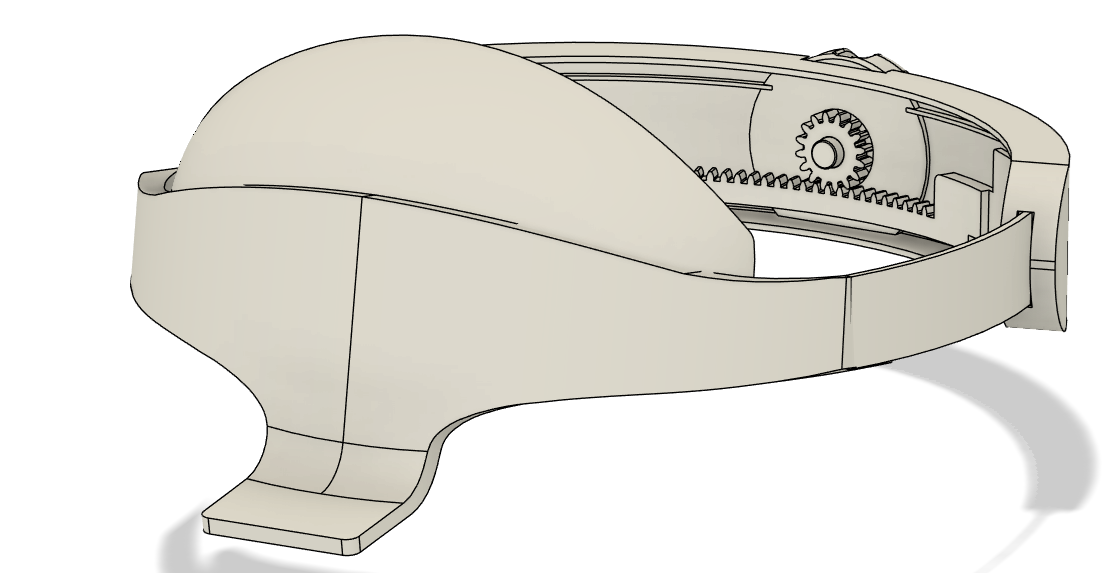
[picture p62: Changelogs/V1.0/Headband/img/2/0.png]
 
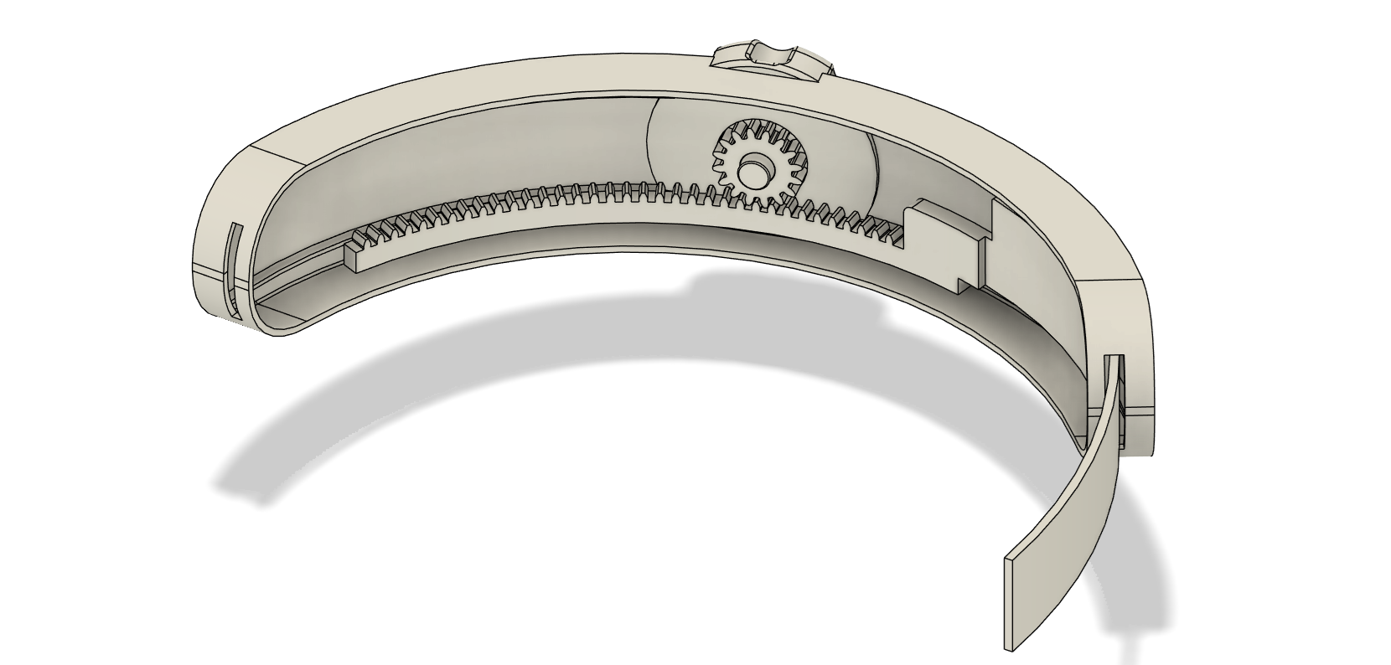
[picture p63: Changelogs/V1.0/Headband/img/2/1.png]
 
 
 ## Headband no.3
 
- Re-meshed the top part of the front
- Adjusted the Knob tolerances
- Adjusted the Strap holes on the rear part
- Added the guide ridges on the strap
- Rounded the edges of the back part
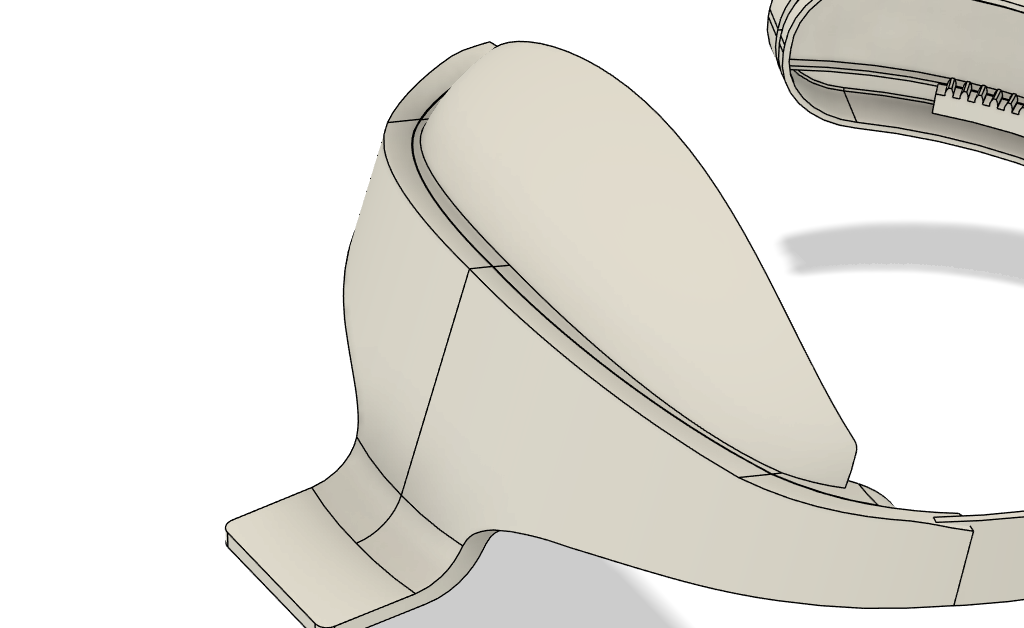
[picture p64: Changelogs/V1.0/Headband/img/3/1.png]

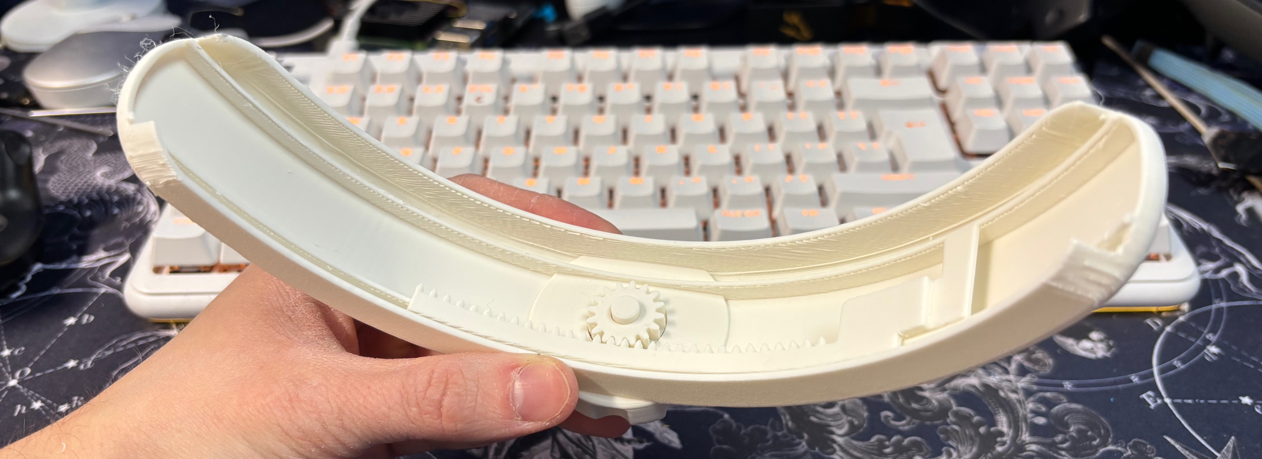
[picture p65: Changelogs/V1.0/Headband/img/3/2.png]

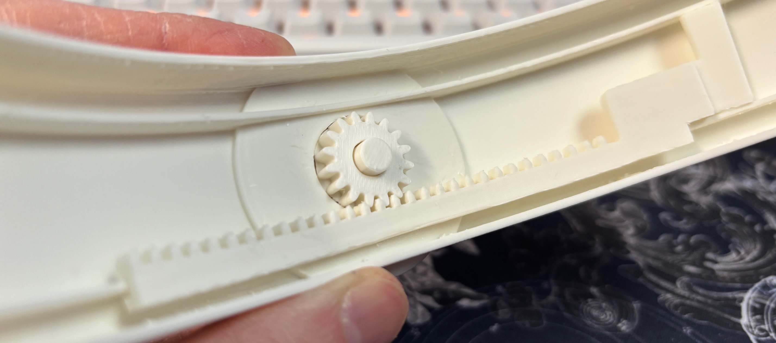
[picture p66: Changelogs/V1.0/Headband/img/3/3.png]

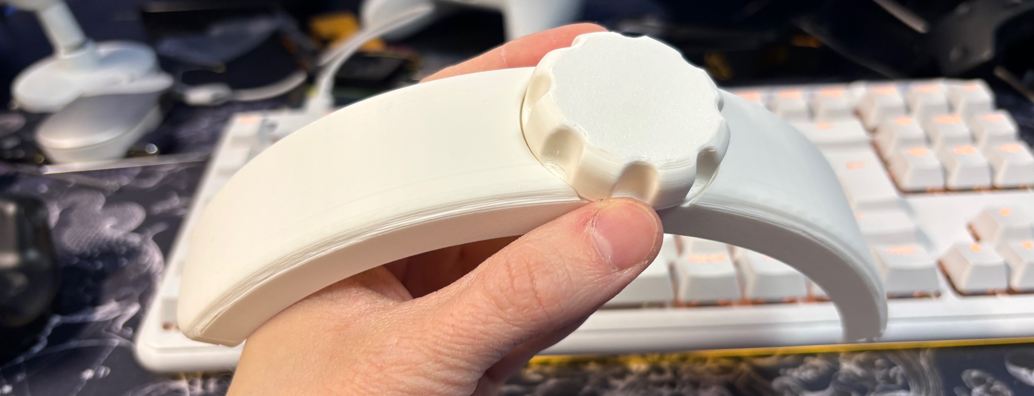
[picture p67: Changelogs/V1.0/Headband/img/3/4.png]


 ## Headband no.4
- Made the strap slightly shorter
- Made the strap ridge taller
- Added a second strap

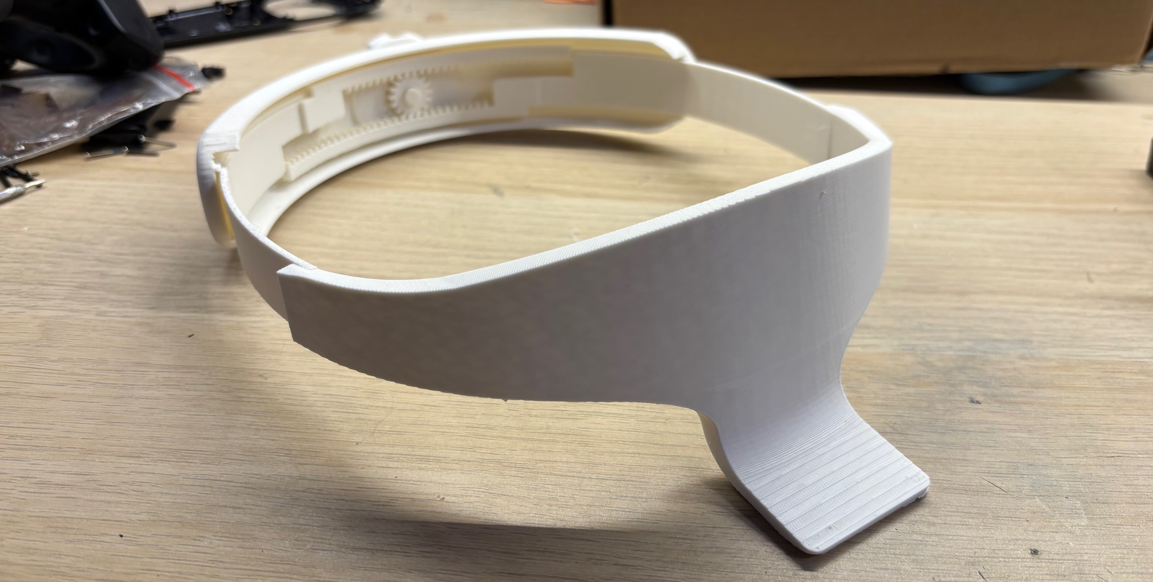
[picture p68: Changelogs/V1.0/Headband/img/4/1.jpeg]

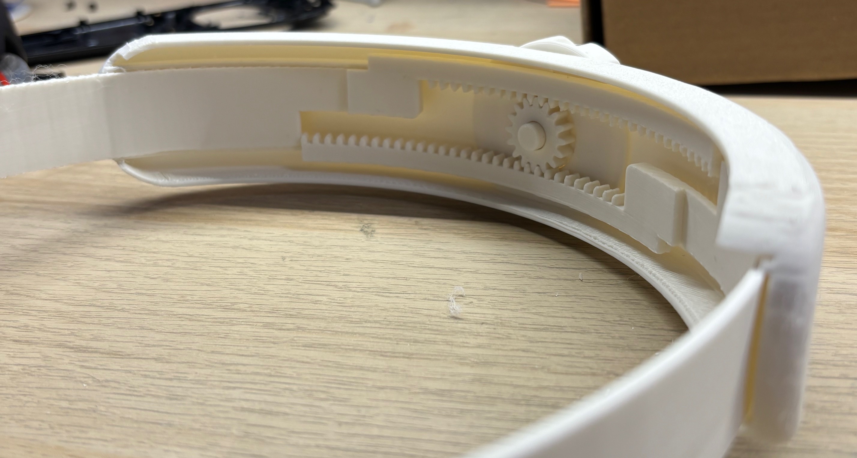
[picture p69: Changelogs/V1.0/Headband/img/4/2.jpeg]

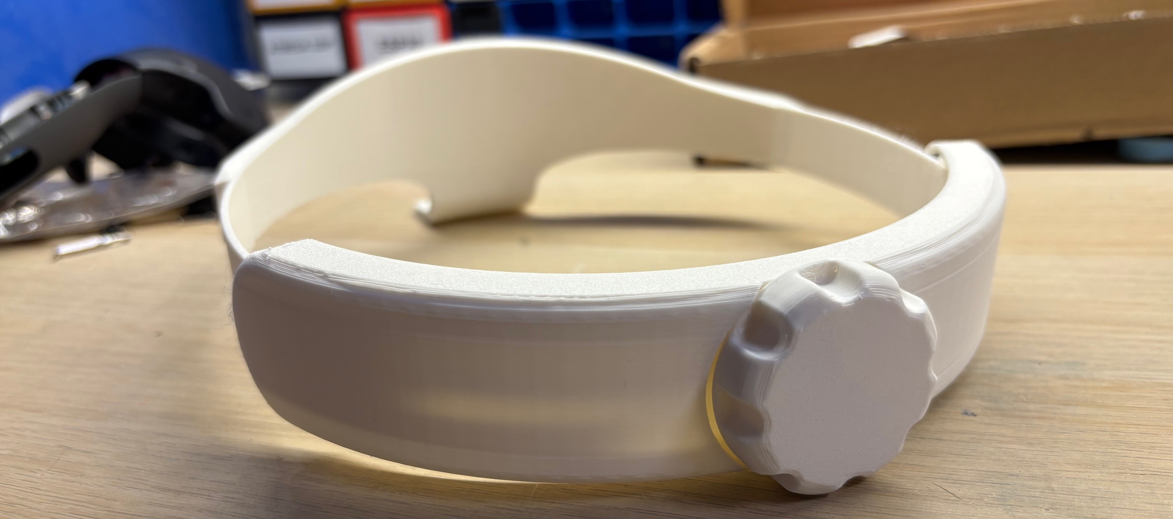
[picture p70: Changelogs/V1.0/Headband/img/4/3.jpeg]


 ## Headband no.5
- Added mounting points to the rear part
- Added mounting points to the top part of headband
- Fixed the strap geometry
- Added gear "endstops" on the straps

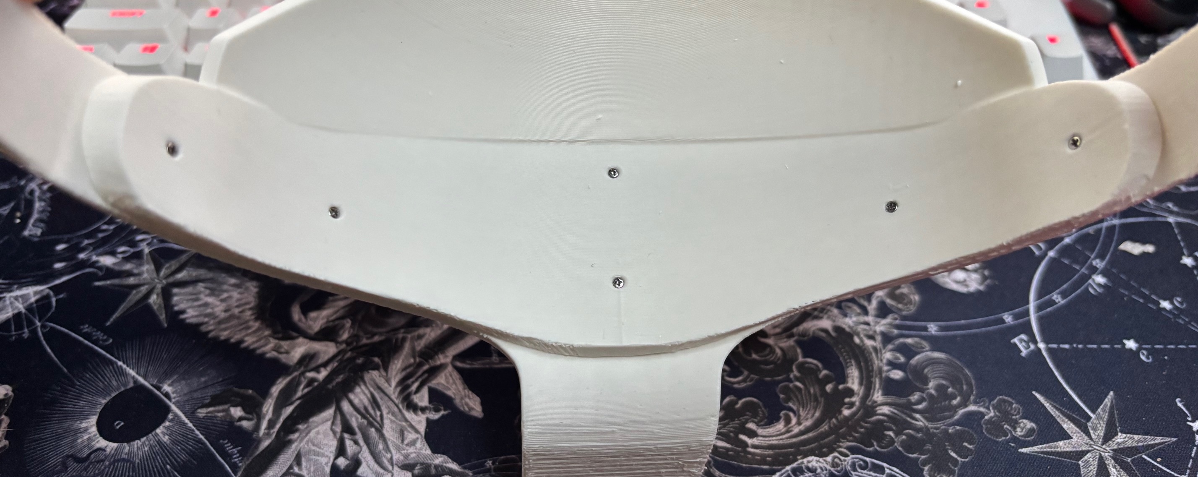
[picture p71: Changelogs/V1.0/Headband/img/5/1.jpeg]

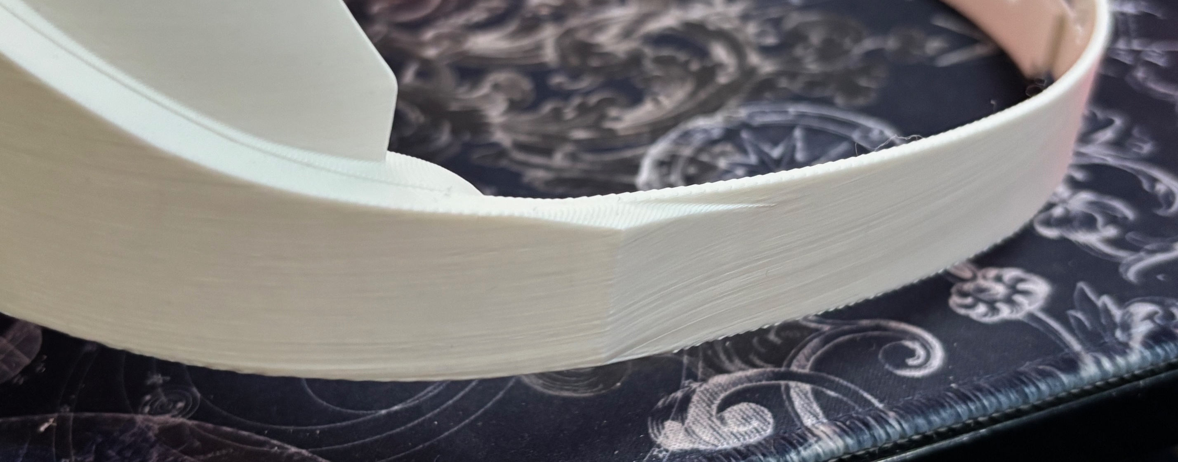
[picture p72: Changelogs/V1.0/Headband/img/5/2.jpeg]

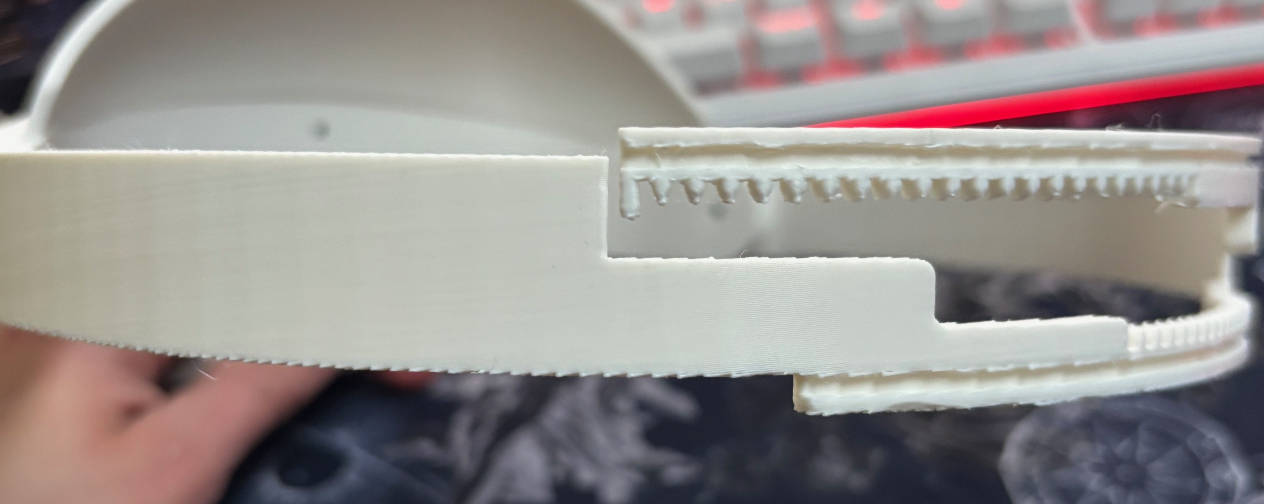
[picture p73: Changelogs/V1.0/Headband/img/5/3.jpeg]


 ## Headband no.6
- Added rear headband cover
- Added Knob lock
- Improved strap holes on the rear part
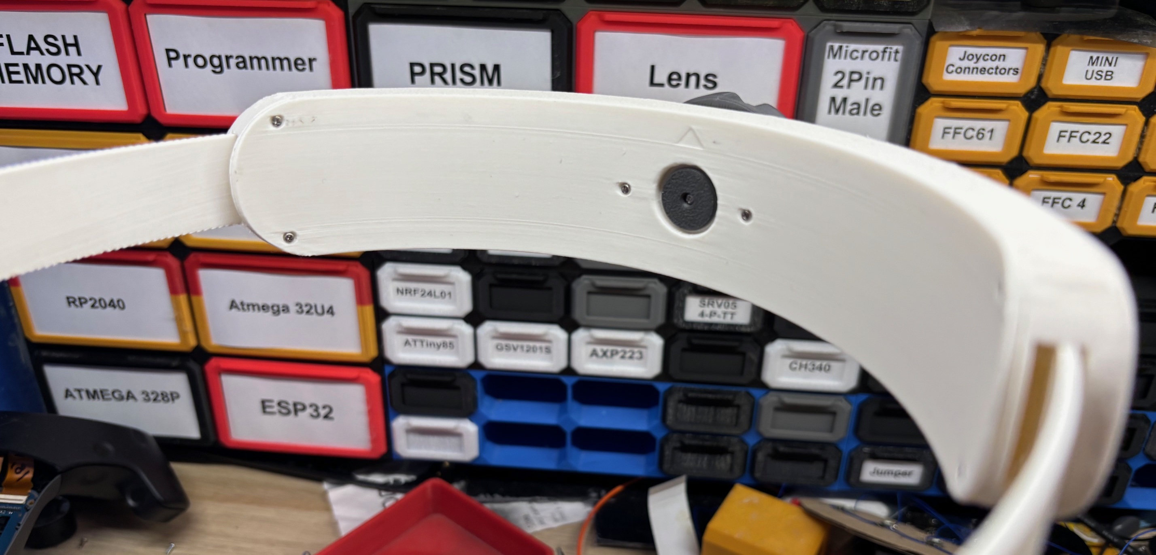
[picture p74: Changelogs/V1.0/Headband/img/6/1.jpeg]

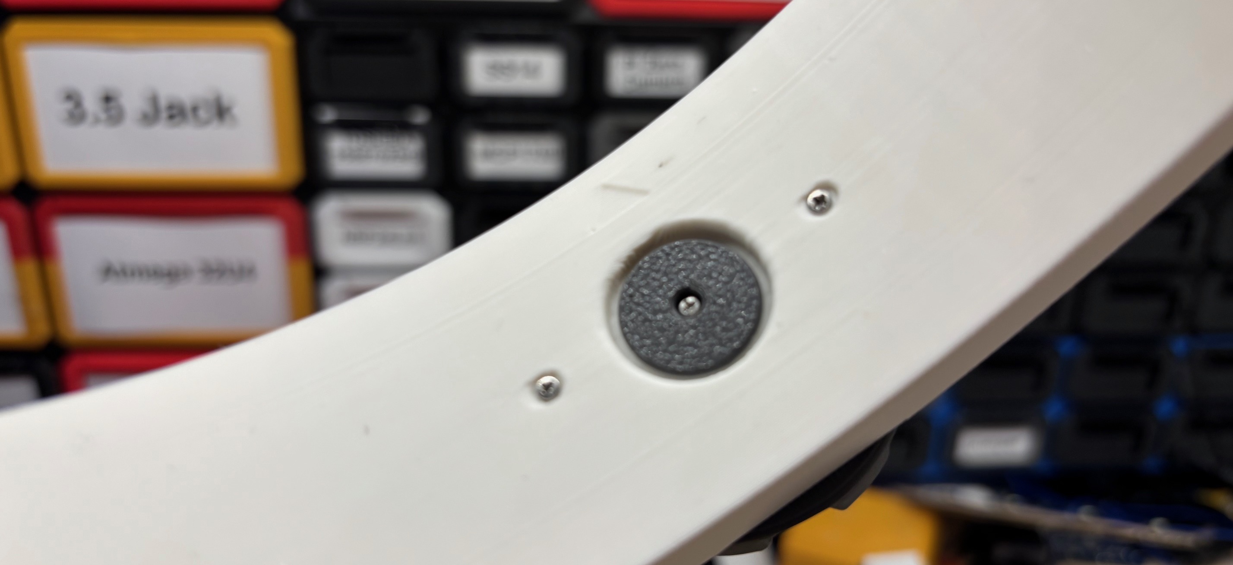
[picture p75: Changelogs/V1.0/Headband/img/6/2.jpeg]


 ## Headband no.7
- Made simple bracket for position and angle calibration
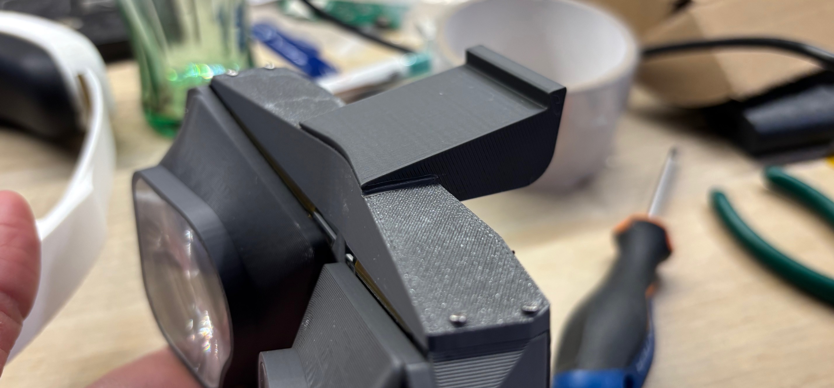
[picture p76: Changelogs/V1.0/Headband/img/7/1.jpeg]

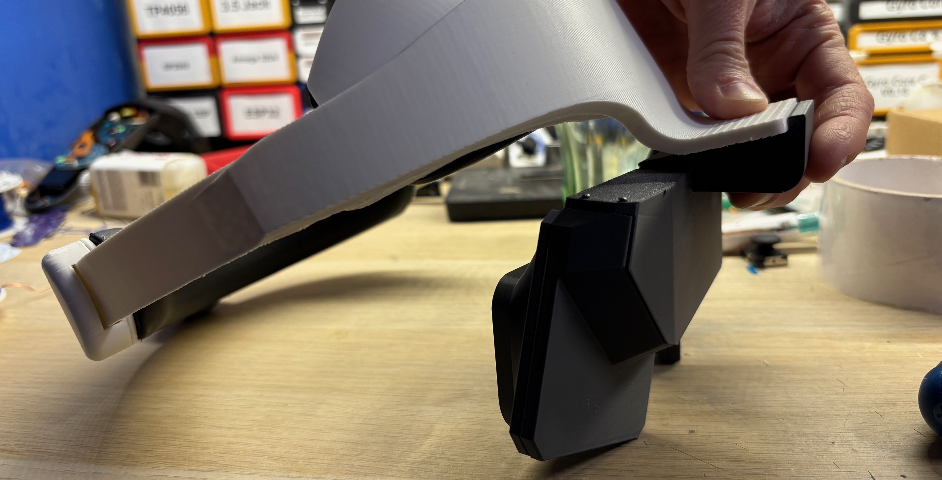
[picture p77: Changelogs/V1.0/Headband/img/7/2.jpeg]


- Applied new offsets to the Headband
- Added Mipi PCB mount to the Headband
- Added mounting points for the Front Housing
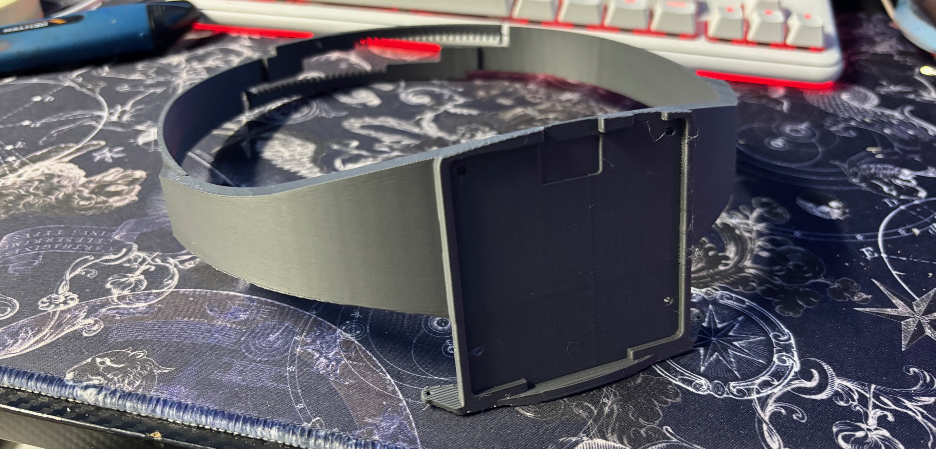
[picture p78: Changelogs/V1.0/Headband/img/7/3.jpeg]

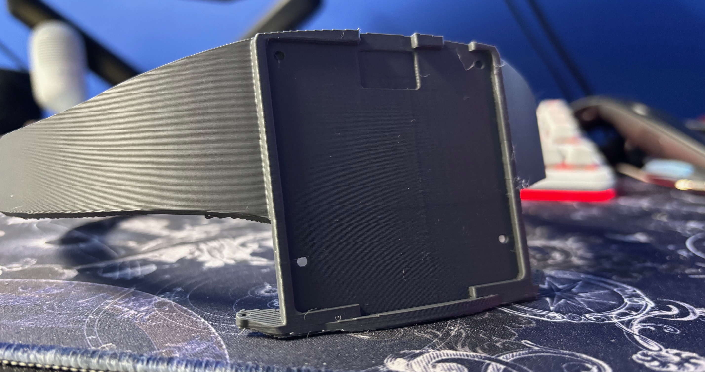
[picture p79: Changelogs/V1.0/Headband/img/7/4.jpeg]

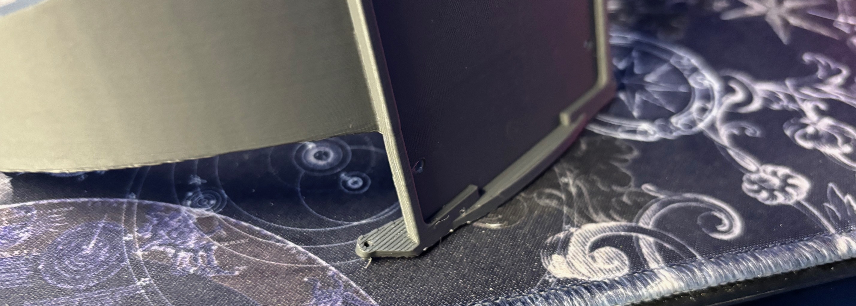
[picture p80: Changelogs/V1.0/Headband/img/7/5.jpeg]


 ## Headband no.8
 - Improved the Knob Gear
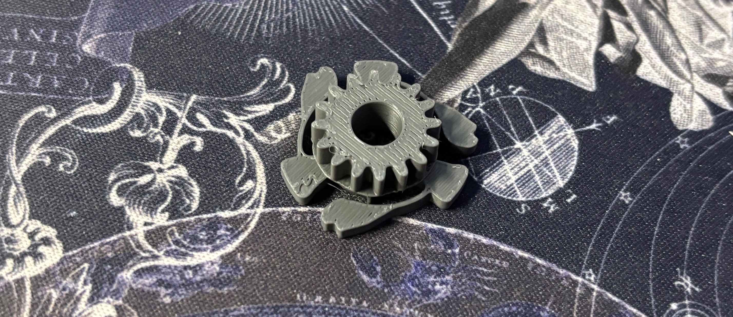
[picture p81: Changelogs/V1.0/Headband/img/8/1.jpeg]
 

- Fixed the geometry near the MIPI PCB bracket
- Improved the MIPI PCB mounting points
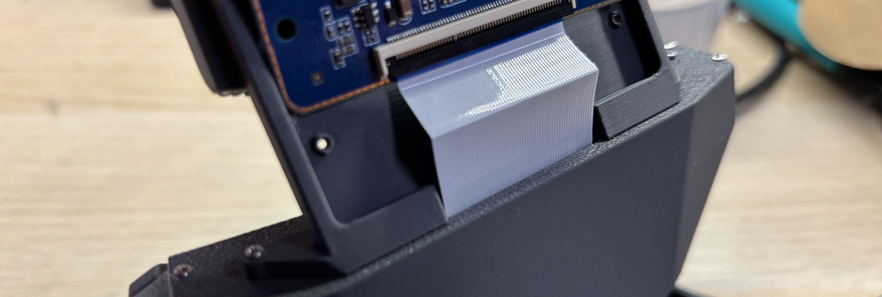
[picture p82: Changelogs/V1.0/Headband/img/8/2.jpeg]
 
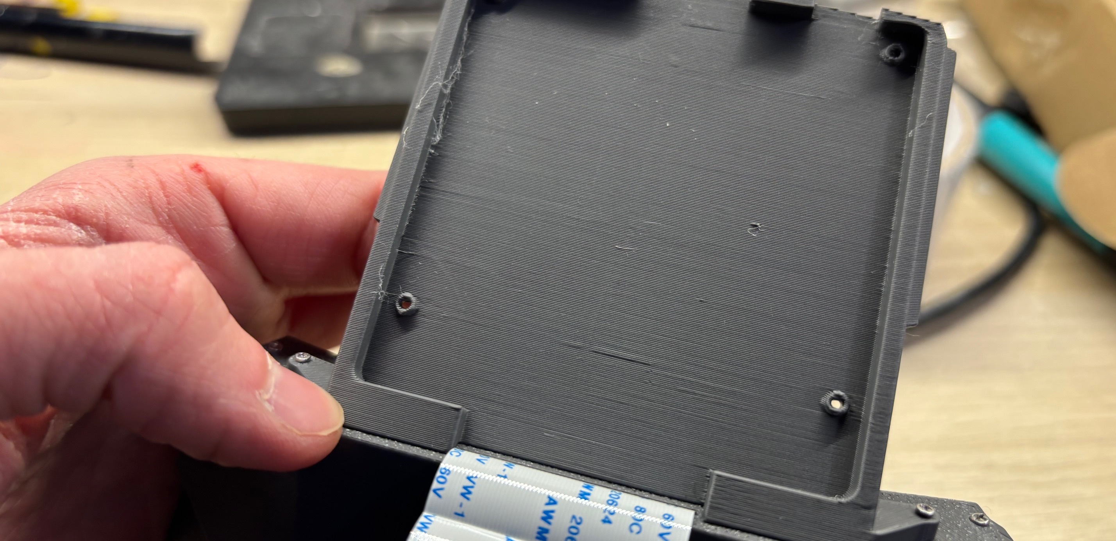
[picture p83: Changelogs/V1.0/Headband/img/8/3.jpeg]
 

## Headband no.9
- Adjusted the mounting points

## 07.02.2026
- Added initial MIPI PCB cover
- Added tracker mount on the Mipi PCB cover
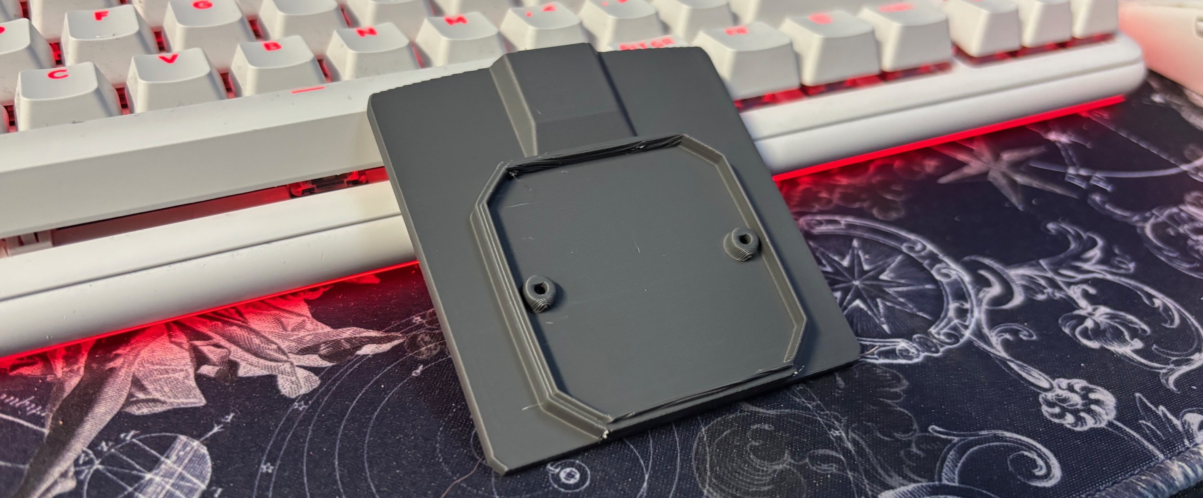
[picture p84: Changelogs/V1.0/Headband/img/07.02.2026/1.jpeg]
 
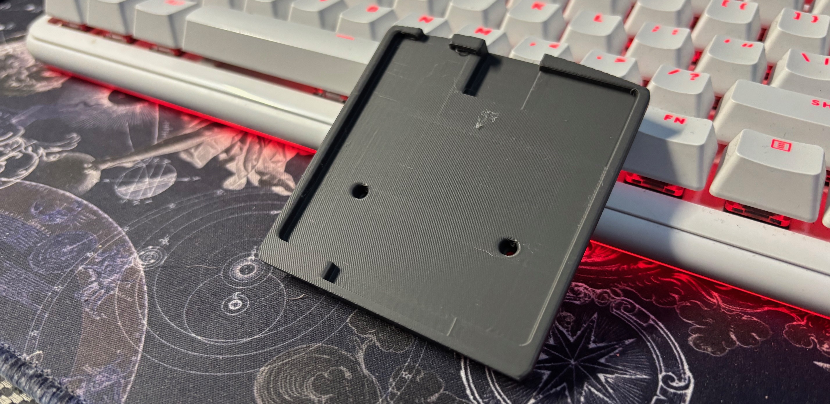
[picture p85: Changelogs/V1.0/Headband/img/07.02.2026/2.jpeg]
 
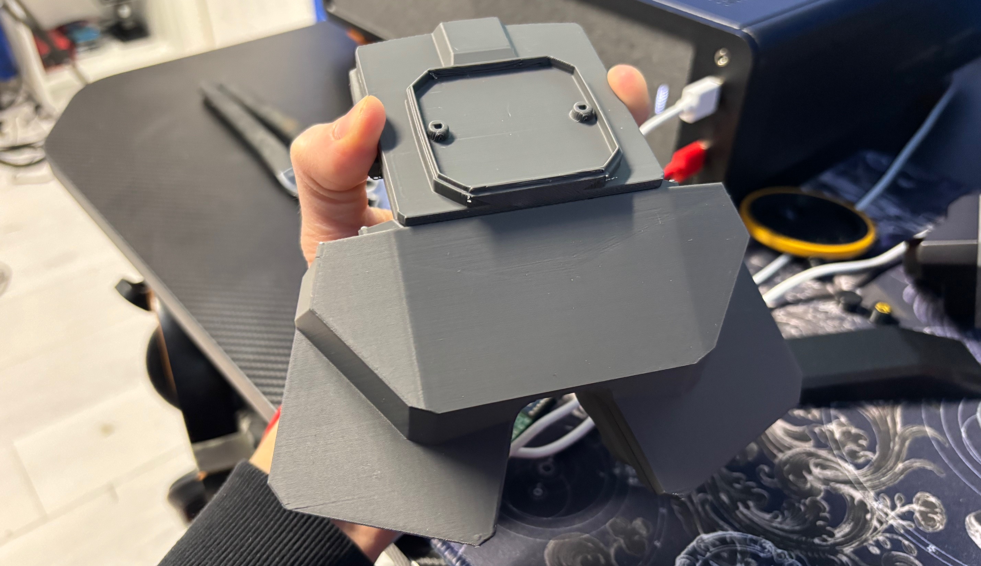
[picture p86: Changelogs/V1.0/Headband/img/07.02.2026/3.jpeg]
  

- Modified the MIPI PCB cover to fit on top of the Headband
- Added mounting points for the MIPI PCB cover
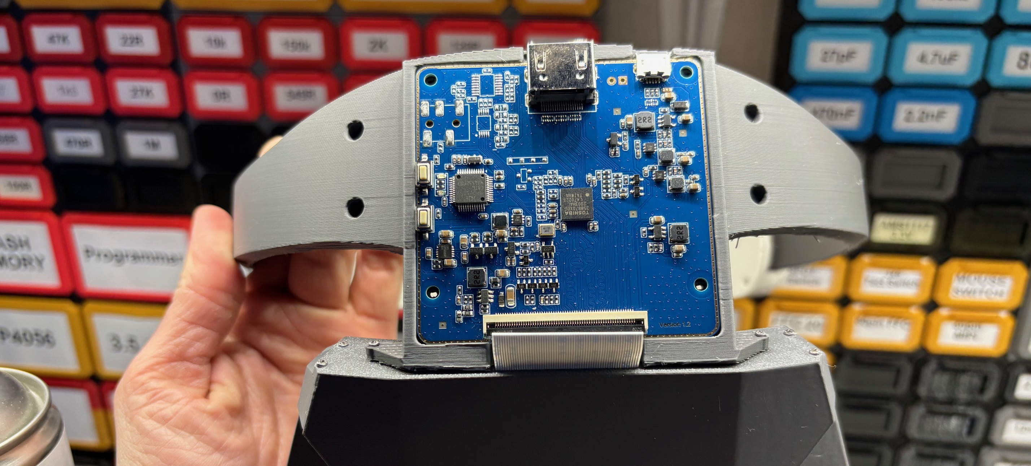
[picture p87: Changelogs/V1.0/Headband/img/07.02.2026/4.jpeg]
  
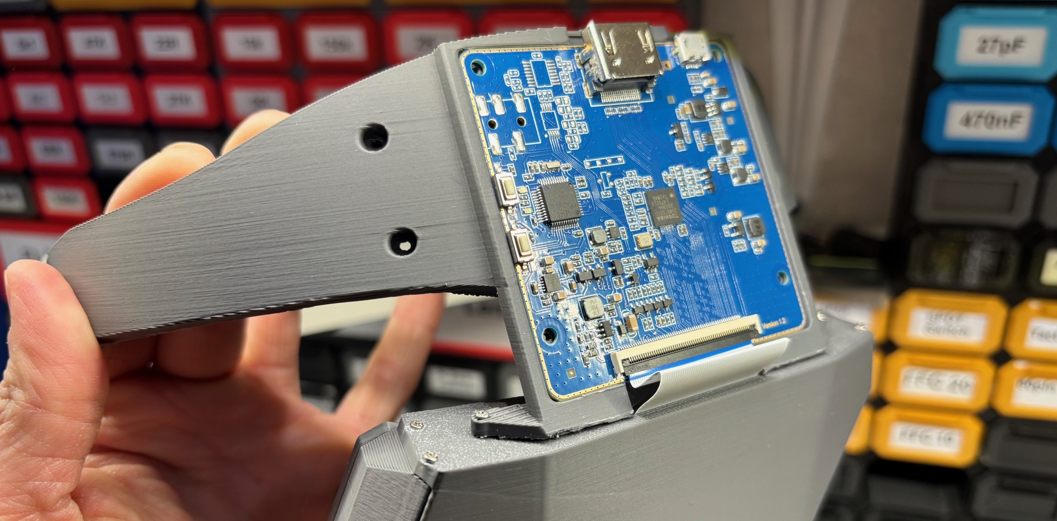
[picture p88: Changelogs/V1.0/Headband/img/07.02.2026/5.jpeg]
  
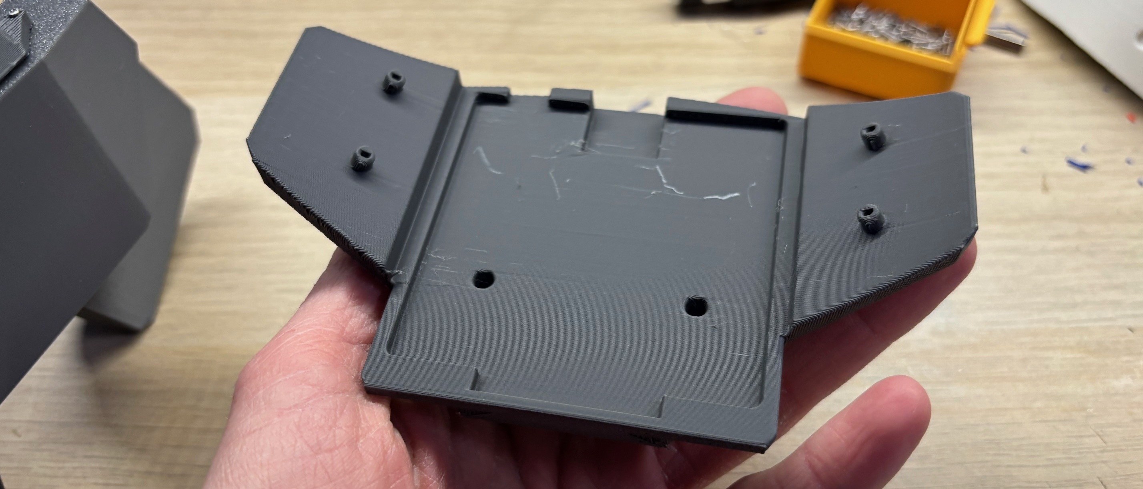
[picture p89: Changelogs/V1.0/Headband/img/07.02.2026/6.jpeg]
  
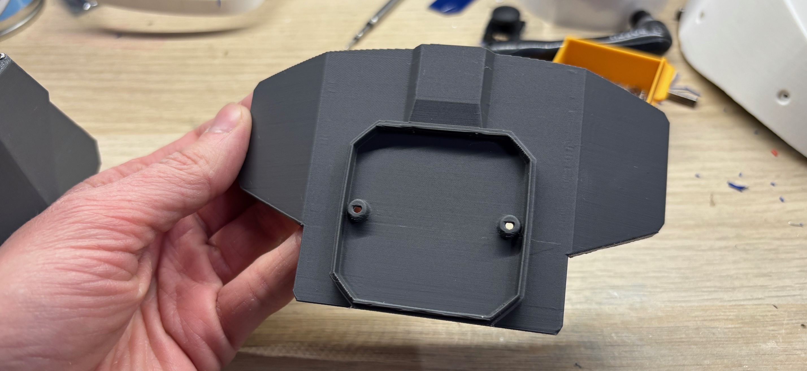
[picture p90: Changelogs/V1.0/Headband/img/07.02.2026/7.jpeg]
