ManoloMancelli/Persephone-3-Pro/Changelogs/V1.0/Front Housing/Front Housing.md

# Persephone 3 Pro Front Housing
Simple 3D printed front piece which closes-up the headset

## Front Housing no. 1
- Modeled the very first version of the Front Housing
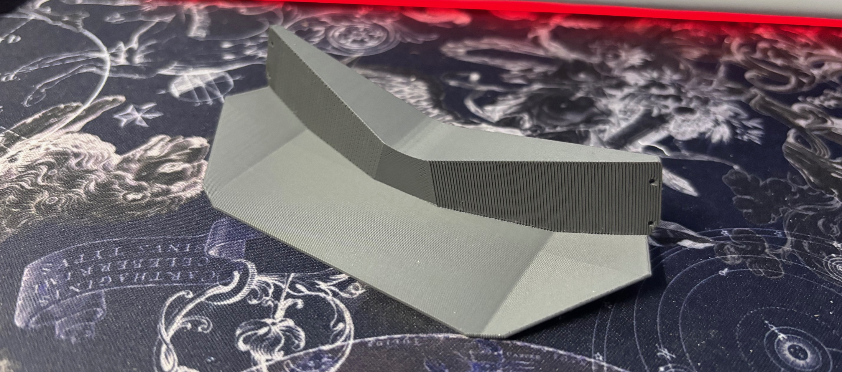
[picture p91: Changelogs/V1.0/Front Housing/img/1/1.jpeg]

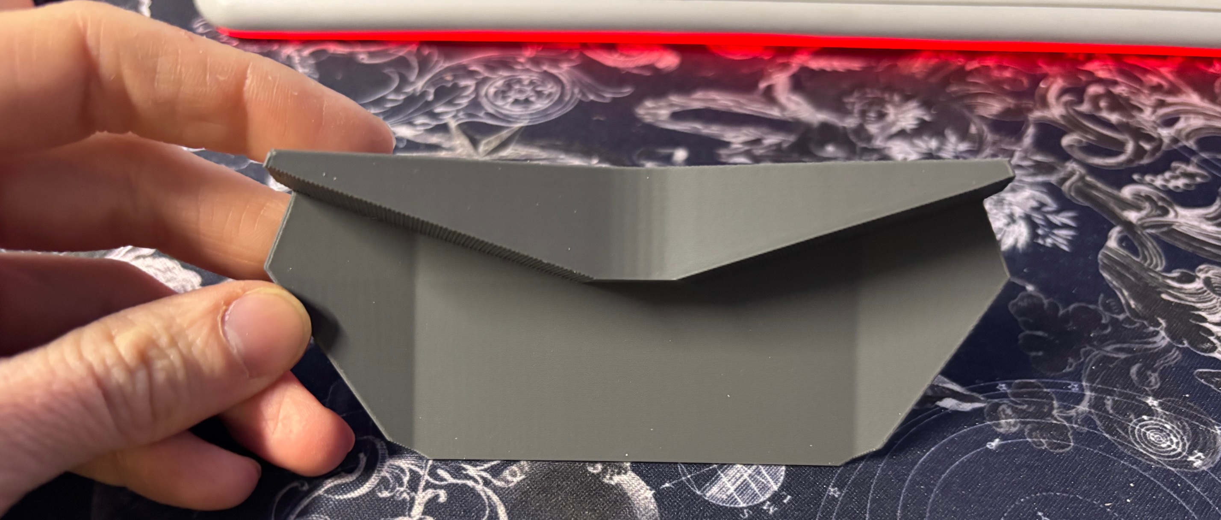
[picture p92: Changelogs/V1.0/Front Housing/img/1/2.jpeg]


## Front Housing no. 2
- Added mounting points for the Headband
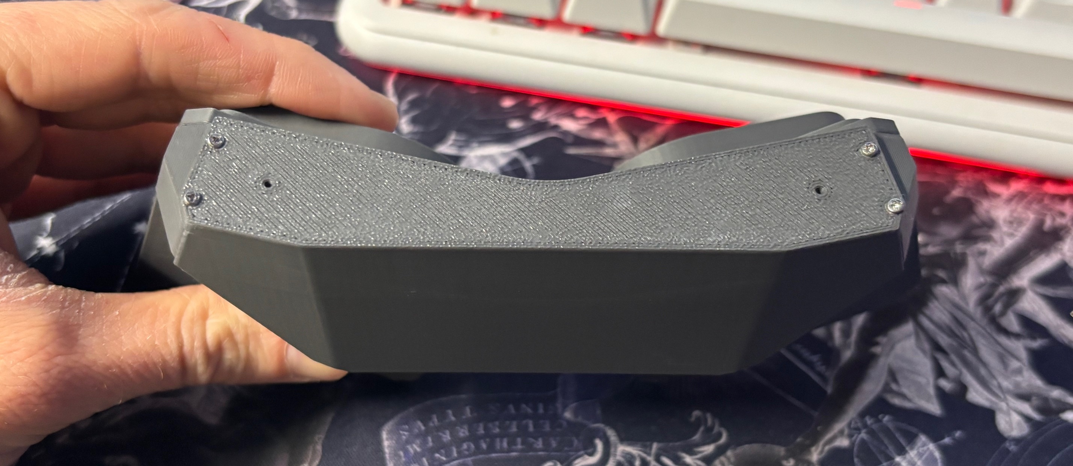
[picture p93: Changelogs/V1.0/Front Housing/img/2/1.jpeg]


## Front Housing no. 3
- Added MIPI PCB FFC slot on top
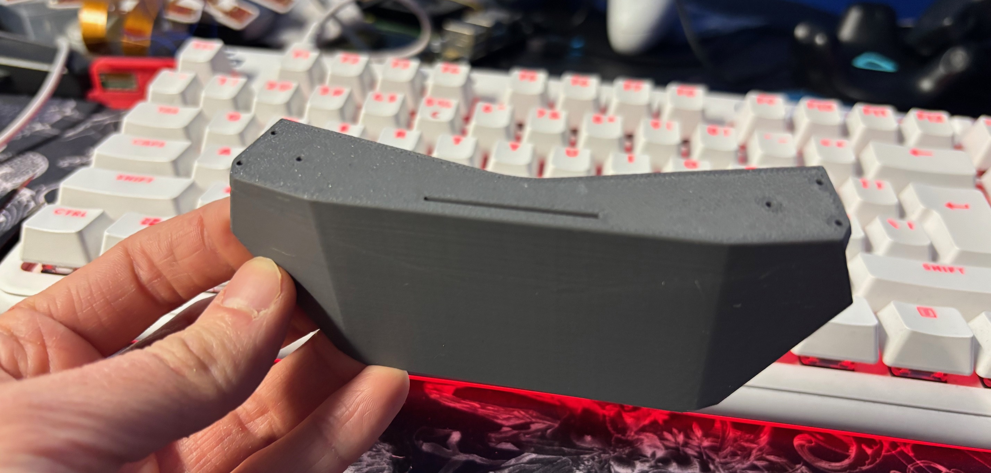
[picture p94: Changelogs/V1.0/Front Housing/img/3/1.jpeg]

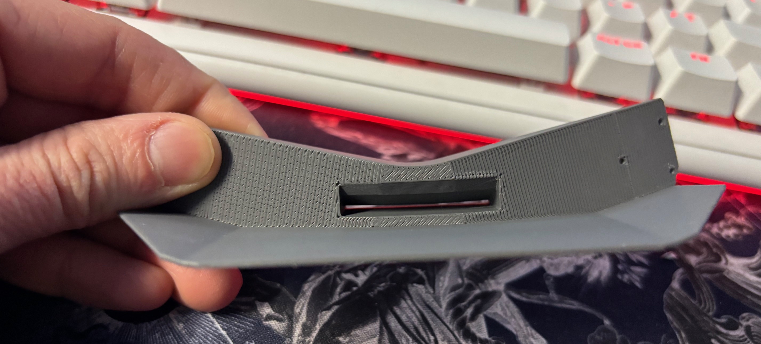
[picture p95: Changelogs/V1.0/Front Housing/img/3/2.jpeg]
