ManoloMancelli/Persephone-3-Pro/(commit log)

2025-12-31 Create Front Housing.md
2025-12-31 Create IPD PCB.md
2025-12-31 Create Eye Tracking Camera.md
2025-12-31 Create Face Tracking Camera.md
2025-12-31 Create Optics Housing.md
2025-12-31 Update Optics Housing.md
2025-12-31 Update Front Housing.md
2025-12-31 Update IPD PCB.md
2025-12-31 Create HDMI Breakout PCB.md
2026-01-01 Update Display Frame.md
