ManoloMancelli/Persephone-3-Pro/(notices)

Notices in the files:
Software/Headset RP2040 - Experimental/sketch 2 - Working but no controllers/headset-NSNextHades/headset-NSNextHades.ino:
Copyright 2022 HadesVR
